daobaitou/STM32_SmartFarm/文档/详细开发计划书.md

# 基于STM32的智能农业监测与灌溉控制系统 — 详细开发计划书

> 编写时间：2026年4月17日
> 适用阶段：毕业设计实施阶段

---

## 一、开发策略原则

### 1.1 核心原则

1. **分阶段、模块化开发**：不追求一次完成所有配置，每个阶段独立验证后再进入下一阶段
2. **先验证后集成**：每个模块单独测试通过后再集成到主工程
3. **从简单到复杂**：从LED闪烁开始，逐步增加功能
4. **保留里程碑版本**：每个阶段完成后保存独立工程备份

### 1.2 开发顺序

```
阶段0: 工程框架搭建 → LED闪烁验证
阶段1: 外设驱动开发（无RTOS，裸机轮询）
阶段2: FreeRTOS集成与任务划分
阶段3: 传感器任务集成
阶段4: 灌溉控制与通信任务
阶段5: 系统联调与优化
阶段6: 上位机与云端开发（并行）
```

---

## 二、阶段0：工程框架搭建（1天）

### 2.1 目标

- 创建基础Keil工程
- 完成STM32CubeMX配置
- 验证编译下载
- LED闪烁测试

### 2.2 任务清单

| 序号 | 任务 | 详细说明 | 完成标准 |
|:----:|---|---|---|
| 0.1 | 创建工程目录 | `Code\STM32_SmartFarm\` | 目录结构完整 |
| 0.2 | CubeMX基础配置 | 按已确认的引脚分配表配置 | 无警告，生成代码成功 |
| 0.3 | Keil工程设置 | 优化等级O2，C99标准，HEX输出 | 编译0 Error 0 Warning |
| 0.4 | ST-Link下载验证 | 连接Blue Pill，下载程序 | 下载成功 |
| 0.5 | LED闪烁测试 | PC13板载LED，1秒闪烁 | LED正常闪烁 |

### 2.3 CubeMX配置要点（已确认方案）

**引脚分配最终版（无冲突）：**

```
模块分类        引脚           功能                配置说明
─────────────────────────────────────────────────────────────
RCC            PH0/PH1        HSE晶振            Crystal/Resonator
SYS            PA13/PA14      SWD调试            Serial Wire

I2C总线        PB6            I2C1_SCL           BH1750+BMP180+OLED+DS3231
               PB7            I2C1_SDA

UART通信       PA9            USART1_TX          串口调试printf (115200bps)
               PA10           USART1_RX
               PA2            USART2_TX          ESP8266 (115200bps)
               PA3            USART2_RX
               PB10           USART3_TX          MH-Z19B (9600bps)
               PB11           USART3_RX

ADC采集        PA0            ADC1_IN0           FC28土壤湿度（已验证）

EXTI中断       PB0            EXTI0              YF-S201水流脉冲（下降沿计数）
               PA5            EXTI5              LM393断电检测（双沿触发）

GPIO输出       PC13           GPIO_Output        板载LED
               PA1            GPIO_Output        DHT22数据引脚
               PA4            GPIO_Output        TB6612 AIN2 风扇控制
               PA6            GPIO_Output        DS18B20数据引脚
               PA7            TIM3_CH2 PWM       SG90舵机窗户控制(50Hz)
               PB1            GPIO_Output        继电器/水泵
               PB8            GPIO_Output        蜂鸣器（低电平触发）
               PB9            GPIO_Output        LED红灯

GPIO输入       PB12           GPIO_Input (PU)    KEY1 模式切换
               PB13           GPIO_Input (PU)    KEY2 水泵开关
               PB14           GPIO_Input (PU)    KEY3 清除报警
               PB15           GPIO_Input (PU)    KEY4 风扇+窗户
```

**时钟配置：**
```
HSE: 8MHz (外部晶振)
PLL: x9 倍频
SYSCLK: 72MHz
APB1: 36MHz (定时器2x = 72MHz)
APB2: 72MHz
```

**需要开启的中断：**
- EXTI line0 (PB0 YF-S201水流脉冲)
- EXTI line5 (PA5 LM393断电检测)
- TIM3 global interrupt (舵机PWM)
- TIM4 global interrupt (HAL timebase)
- USART2 global interrupt (ESP8266 UART)

### 2.4 需避免的引脚（Blue Pill JTAG冲突）

```
禁止使用: PA15, PB3, PB4 (JTAG引脚，即使SWD模式也有冲突)
谨慎使用: PA8 (可能有时钟相关冲突)
```

### 2.5 阶段验收

- [x] Keil工程编译成功
- [x] 程序下载成功
- [x] PC13 LED以1秒周期闪烁
- [x] 保存工程备份：已完成多个里程碑版本(v0~v1.4)

---

## 三、阶段1：外设驱动开发（5-7天）

### 1.1 目标

- 裸机环境下完成所有传感器驱动
- 通过串口打印验证每个传感器数据
- 不引入RTOS，使用简单的delay轮询

### 1.2 模块开发顺序

#### 模块1.1：串口调试输出（0.5天） ✅ 已完成

| 任务 | 说明 |
|---|---|
| 重定向printf | 使用USART1，115200bps |
| 测试代码 | `printf("System Init OK\r\n");` |
| 验收标准 | 串口助手收到打印信息 |

**代码结构：**
```
App/
├── Utils/
│   ├── retarget.c      # printf重定向
│   └── retarget.h
```

#### 模块1.2：DHT22温湿度传感器（0.5天） ✅ 已完成

| 任务 | 说明 |
|---|---|
| 接口 | PA1，单总线协议 |
| 时序要求 | 起始信号>1ms，响应80us，数据位50us周期 |
| 数据格式 | 40位（湿度整数+小数+温度整数+小数+校验和） |
| 采集周期 | ≥2秒 |

**驱动接口设计：**
```c
typedef struct {
    float temperature;    // 温度(°C)
    float humidity;       // 湿度(%RH)
    uint8_t valid;        // 数据有效标志
} DHT22_Data_t;

HAL_StatusTypeDef DHT22_Init(void);
HAL_StatusTypeDef DHT22_Read(DHT22_Data_t *data);
```

**验收标准：** 串口打印 `DHT22: T=25.6°C, H=65.2%RH`

#### 模块1.3：DS18B20土壤温度（0.5天） ✅ 已完成

| 任务 | 说明 |
|---|---|
| 接口 | PA6，单总线协议 |
| 精度 | ±0.5°C |
| 转换时间 | 750ms（12位分辨率） |

**驱动接口设计：**
```c
typedef struct {
    float temperature;    // 温度(°C)
    uint8_t valid;
} DS18B20_Data_t;

HAL_StatusTypeDef DS18B20_Init(void);
HAL_StatusTypeDef DS18B20_Read(DS18B20_Data_t *data);
```

**验收标准：** 串口打印 `DS18B20: T=22.1°C`

#### 模块1.4：BH1750光照强度（0.5天） ✅ 已完成（软件I2C）

| 任务 | 说明 |
|---|---|
| 接口 | GPIO模拟I2C (PB6/PB7) |
| 地址 | 0x23 |
| 量程 | 1-65535 lux |
| 特殊处理 | 单次触发模式 + 数据合理性校验 |

**驱动接口设计：**
```c
typedef struct {
    float light;         // 光照强度(lux)
    uint8_t valid;
} BH1750_Data_t;

HAL_StatusTypeDef BH1750_Init(void);
HAL_StatusTypeDef BH1750_Read(BH1750_Data_t *data);
```

**验收标准：** 串口打印 `BH1750: Light=850 lux`

#### 模块1.5：BMP180大气压强（0.5天） ✅ 已完成（软件I2C）

| 任务 | 说明 |
|---|---|
| 接口 | GPIO模拟I2C (PB6/PB7) |
| 地址 | 0x77 |
| 测量内容 | 大气压强(hPa) + 温度补偿 |
| 特殊处理 | EPROM校准参数读取 + Bosch补偿公式 |

**驱动接口设计：**
```c
typedef struct {
    float pressure;       // 大气压强(hPa)
    float temperature;    // 芯片温度(°C)
    uint8_t valid;
} BMP180_Data_t;

HAL_StatusTypeDef BMP180_Init(void);
HAL_StatusTypeDef BMP180_Read(BMP180_Data_t *data);
```

**验收标准：** 串口打印 `BMP180: P=1013.2 hPa`

#### 模块1.6：MH-Z19B CO2传感器（1天） ✅ 已完成

| 任务 | 说明 |
|---|---|
| 接口 | USART3 (PB10/PB11)，9600bps |
| 通信协议 | 9字节命令帧 |
| 预热时间 | 3分钟 |

**命令帧格式：**
```
读取命令: 0xFF 0x01 0x86 0x00 0x00 0x00 0x00 0x00 0x79
返回格式: 0xFF 0x86 [高字节] [低字节] ... [校验和]
```

**驱动接口设计：**
```c
typedef struct {
    uint16_t ppm;         // CO2浓度(ppm)
    uint8_t valid;
} MHZ19B_Data_t;

HAL_StatusTypeDef MHZ19B_Init(void);
HAL_StatusTypeDef MHZ19B_Read(MHZ19B_Data_t *data);
```

**验收标准：** 串口打印 `MH-Z19B: CO2=420 ppm`

#### 模块1.7：FC28土壤湿度ADC（0.5天） ✅ 已完成

| 任务 | 说明 |
|---|---|
| 接口 | ADC1_IN0 (PA0) |
| 输出范围 | 0-4095（12位ADC） |
| 湿度映射 | 干燥≈4095，湿润≈1000（需校准） |

**驱动接口设计：**
```c
HAL_StatusTypeDef FC28_Init(void);
HAL_StatusTypeDef FC28_Read(uint16_t *adc_value, uint8_t *moisture_percent);
```

**验收标准：** 串口打印 `FC28: ADC=2500, Moisture=45%`

#### 模块1.8：水位传感器ADC（0.5天）

| 任务 | 说明 |
|---|---|
| 接口 | ADC1_IN4 (PA4) |
| 输出范围 | 0-4095 |
| 水位映射 | 低水位≈500，满水≈3500（需校准） |

**验收标准：** 串口打印 `WaterLevel: 75%`

#### 模块1.9：LM393雨滴检测（0.5天）

| 任务 | 说明 |
|---|---|
| 接口 | ADC1_IN5 (PA5)，可选数字输出DO |
| 检测逻辑 | 无雨≈4095，有雨<3000 |

**验收标准：** 串口打印 `Rain: No/Yes`

#### 模块1.10：YF-S201水流传感器（1天） ✅ 驱动完成（硬件接线待确认）

| 任务 | 说明 |
|---|---|
| 接口 | PB0 (EXTI0)，下降沿中断计数 |
| 原理 | 脉冲计数，频率与流速成正比 |
| 流速公式 | 流速(L/min) = 脉冲频率 / 7.5 |

**驱动接口设计：**
```c
HAL_StatusTypeDef YFS201_Init(void);
float YFS201_GetFlowRate(void);      // 流速(L/min)
float YFS201_GetTotalVolume(void);   // 累计流量(L)
void YFS201_ResetVolume(void);
```

**验收标准：** 串口打印 `Flow: 1.2 L/min, Total: 5.6 L`

#### 模块1.11：OLED显示（1天） ✅ 已完成（软件I2C + 批量刷新）

| 任务 | 说明 |
|---|---|
| 接口 | GPIO模拟I2C (PB6/PB7) |
| 型号 | SSD1306，128x64，地址0x3C |
| 特殊处理 | 批量页刷新(8次I2C事务而非1024次) |

**驱动接口设计：**
```c
HAL_StatusTypeDef OLED_Init(void);
void OLED_Clear(void);
void OLED_Refresh(void);
void OLED_DrawString(uint8_t x, uint8_t y, const char *str, uint8_t font_size);
void OLED_Fill(uint8_t data);
```

**验收标准：** OLED显示温湿度数据

#### 模块1.12：DS3231 RTC时钟（0.5天）

| 任务 | 说明 |
|---|---|
| 接口 | I2C1 (PB6/PB7) |
| 地址 | 0xD0（写）/ 0xD1（读） |
| 功能 | 年月日时分秒，断电保持 |

**验收标准：** 串口打印 `Time: 2026-04-17 14:30:25`

#### 模块1.13：水泵控制（MOS驱动） ✅ 已完成

| 任务 | 说明 |
|---|---|
| 接口 | PB1，GPIO输出 + MOS模块 |
| 控制逻辑 | 高电平开启，低电平关闭 |
| 驱动方式 | MOS模块（5V供电），与风扇方案一致 |

**硬件接线：**
```
STM32 PB1 ─── MOS模块IN
MOS模块VCC ─── 5V
MOS模块GND ─── GND
MOS输出 ─── 12V水泵正极
水泵负极 ─── GND
```

**验收标准：** 水泵可手动/自动开关

#### 模块1.14：蜂鸣器与LED报警（0.5天）

| 任务 | 说明 |
|---|---|
| 蜂鸣器 | PB8，GPIO输出 |
| LED红灯 | PB9，GPIO输出 |

**验收标准：** 声光报警正常工作

#### 模块1.15：按键输入（0.5天）

| 任务 | 说明 |
|---|---|
| 接口 | PB12/PB13/PB14/PB15，上拉输入 |
| 检测方式 | 轮询扫描，消抖20ms |

**验收标准：** 按键触发串口打印

### 1.3 阶段验收清单

- [x] DHT22温湿度读取正常
- [x] DS18B20土壤温度读取正常
- [x] BH1750光照强度读取正常
- [x] BMP180大气压强读取正常
- [x] MH-Z19B CO2浓度读取正常（已集成，含预热+量程过滤）
- [x] FC28土壤湿度ADC读取正常
- [ ] 水位传感器ADC读取正常
- [ ] LM393雨滴检测正常
- [x] YF-S201水流计量正常（驱动完成，硬件接线已确认）
- [x] OLED显示正常
- [x] W25Q64 Flash存储正常（配置参数+数据日志）
- [x] DHT22添加4.7K上拉电阻后正常工作（26.3°C / 49%）
- [ ] DS3231时间读取正常
- [x] 水泵控制正常（PB1, MOS驱动，高电平ON）
- [x] 蜂鸣器+LED报警正常（PB8低电平触发3pin蜂鸣器+PB9 LED）
- [x] 按键响应正常（4键，50ms消抖+单次触发+短"滴"声确认）
- [x] 断电检测驱动完成（LM393比较器，PA5双沿EXTI中断）
- [x] 保存工程备份：`STM32_SmartFarm_v1_Sensors/`

---

## 四、阶段2：FreeRTOS集成（2-3天） ✅ 已完成

### 2.1 目标

- 将FreeRTOS内核集成到工程
- 创建基础任务框架
- 验证任务调度正常

### 2.2 任务清单

#### 2.1 FreeRTOS移植（1天） ✅ 已完成

| 任务 | 说明 |
|---|---|
| 源码添加 | 使用 `FreeRTOSv202411.00` |
| 配置文件 | `FreeRTOSConfig.h` 时钟72MHz，堆8KB |
| 堆管理 | 选择 `heap_4.c` |
| HAL timebase | 重写`HAL_InitTick()`用TIM4替代SysTick |
| 中断接管 | SysTick→FreeRTOS, PendSV/SVC→FreeRTOS |

**FreeRTOSConfig.h 实际配置：**
```c
#define configCPU_CLOCK_HZ          (72000000UL)
#define configTICK_RATE_HZ          (1000)        // 1ms tick
#define configTOTAL_HEAP_SIZE       ((size_t)(15 * 1024))  // 15KB
#define configUSE_PREEMPTION         1
#define configUSE_MUTEXES            1
#define configUSE_COUNTING_SEMAPHORES 1
#define configUSE_TIMERS             1
#define configMAX_PRIORITIES         (7)
```

#### 2.2 创建基础任务（1天） ✅ 已完成

**实际任务分配（v4.3 完整版）：**
```c
#define PRIORITY_IRRIGATION 6   // 灌溉+风扇+窗户+按键（独占最高优先级）
#define PRIORITY_UART_RX   4   // 接收控制命令
#define PRIORITY_SENSOR     3   // 传感器采集
#define PRIORITY_LCD        2   // OLED显示
#define PRIORITY_UART_TX    2   // 发送传感器数据
#define PRIORITY_PRINT      2   // 串口打印
#define PRIORITY_LED        0   // LED闪烁
```

**任务栈与功能：**
| 任务 | 栈(字) | 优先级 | 功能 |
|---|---|---|---|
| vTask_Irrigation | 384 | 6 | 灌溉+风扇+窗户控制、4键响应、报警判断（不用printf） |
| vTask_Sensor | 512 | 3 | 每2秒采集所有传感器（含CO2），发送队列(3份) |
| vTask_LCD | 384 | 2 | 接收数据，OLED显示（I2C互斥保护） |
| vTask_UART_TX | 256 | 2 | 接收数据，通过UART协议发送到ESP8266 |
| vTask_Print | 256 | 2 | 接收数据，串口打印（不用float printf） |
| vTask_UART_RX | 128 | 4 | 从ESP8266接收控制命令 |
| vTask_LED | 128 | 0 | PC13每500ms翻转 |

**数据通信：**
- 队列：`xQueue_SensorData`（长度3，发送3份给3个消费者）
- 队列：`xQueue_ControlCmd`（长度4，控制命令）
- 互斥量：`xMutex_I2C`（保护共享I2C总线）

**SensorData_t 结构：**
```c
typedef struct {
    float temperature, humidity, soil_temp, pressure, bmp_temp;
    float light, flow_rate, total_volume;
    uint8_t soil_moisture;
    uint16_t adc_raw, co2;
    uint32_t timestamp;
} SensorData_t;
```

#### 2.3 关键技术要点

1. **SysTick冲突解决**：重写`HAL_InitTick()`用TIM4替代SysTick
2. **中断向量映射**：SysTick_Handler→xPortSysTickHandler, PendSV→xPortPendSVHandler, SVC→vPortSVCHandler
3. **TIM4配置**：72分频→1MHz，周期1000→1ms，NVIC优先级最低(15)
4. **I2C互斥保护**：LCD任务通过mutex独占I2C总线，防止与BH1750/BMP180冲突
5. **Windows大小写问题**：`freertos.h`与`FreeRTOS.h`冲突，改名为`app_tasks.h`

#### 2.4 阶段验收

- [x] FreeRTOS编译通过
- [x] 任务调度正常（LED闪烁、串口打印、OLED刷新）
- [x] 消息队列通信正常
- [x] I2C互斥量工作正常
- [x] 保存工程备份：阶段2集成完成

---

## 五、阶段3：传感器任务集成（3-4天） ✅ 已完成（与阶段2合并）

### 3.1 目标

- 将阶段1的驱动集成到FreeRTOS任务
- 实现数据采集队列通信
- OLED实时显示

### 3.2 实际实现

传感器采集、队列通信、OLED显示已在阶段2一并实现：
- `vTask_Sensor`：每2秒采集DHT22/DS18B20/FC28/BMP180/BH1750/YFS201
- `vTask_LCD`：接收队列数据，通过I2C互斥量保护OLED刷新
- `vTask_Print`：接收队列数据，串口格式化打印

### 3.3 测试结果

```
[Sensor] DHT22 failed          ← 传感器未连接
[Sensor] FC28: 100%
[Sensor] BMP180: 803hPa
[Sensor] BH1750: 200lux
[Sensor] Data sent to queue
[LCD] OLED refreshed
[LED] Toggle #22
```

### 3.4 阶段验收

- [x] 已有传感器数据正常采集（DHT22已添加上拉电阻，26.3°C/49%正常读取）
- [x] 消息队列数据传输正常
- [x] OLED实时刷新显示
- [ ] MH-Z19B/水位/雨滴传感器待硬件到位后集成

---

## 六、阶段4：通信与灌溉控制（4-5天） ✅ 已完成（v3.0 + v4.0架构重构）

### 4.1 目标

- ESP8266 MQTT通信
- 灌溉控制逻辑
- 断电检测响应

### 4.2 架构演进（重要）

#### v3.0 旧架构（已废弃）

```
STM32(传感器+AT命令+MQTT协议编码) → ESP8266(AT被动响应)
```

STM32承担了过多通信协议处理工作，20KB RAM不足以支撑AT命令解析+MQTT协议编码+多任务栈，接上ESP8266后系统崩溃。

#### v4.0 新架构（当前方案）

```
STM32(传感器采集) ←UART文本协议→ ESP8266(Arduino独立固件+WiFi+MQTT)
```

**ESP8266独立运行Arduino固件**，自己处理WiFi连接、MQTT通信和JSON格式转换：
- 位置：`Code/ESP8266_MQTT_Bridge/`
- 库依赖：PubSubClient（MQTT）、ArduinoJson v6（JSON）
- SoftwareSerial (D7/D8) 与 STM32 通信
- 自动 WiFi + MQTT 重连

**STM32 精简**：
- 删除 `esp8266_at.c/h`（AT命令驱动）
- 删除 `esp_mqtt.c/h`（MQTT协议编码）
- 新增 `uart_bridge.c/h`（简单UART文本协议）
- 新增 `servo_control.c/h`（SG90舵机PWM驱动）
- 新增 `fan_control.c/h`（TB6612风扇GPIO驱动）
- 释放约 2.6KB RAM

### 4.3 UART文本协议

**STM32 → ESP8266**（传感器数据）：
```
SNS:{"t":25.6,"h":65.2,"sm":42,"st":22.1,"l":850,"p":1013.2,"c":420,"f":0.0,"v":0.0}\n
```

**ESP8266 → STM32**（控制命令）：
```
CMD:MODE:AUTO\n      /  CMD:MODE:MANUAL\n
CMD:PUMP:ON\n        /  CMD:PUMP:OFF\n
CMD:THRESH:35:70\n
CMD:FAN:ON\n         /  CMD:FAN:OFF\n
CMD:WDOW:OPEN\n      /  CMD:WDOW:CLOSE\n
ACK:SNS\n            /  NACK:SNS\n
```

### 4.4 STM32通信任务

```c
// UART_TX任务 - 发送传感器数据到ESP8266
void vTask_UART_TX(void *pvParameters)
{
    SensorData_t data;
    for (;;) {
        if (xQueueReceive(xQueue_SensorData, &data, portMAX_DELAY) == pdTRUE) {
            UART_Bridge_SendSensorData(&data);
        }
    }
}

// UART_RX任务 - 接收ESP8266控制命令
void vTask_UART_RX(void *pvParameters)
{
    BridgeCmd_t bridgeCmd;
    ControlCmd_t ctrlCmd;
    for (;;) {
        if (UART_Bridge_CheckCommand(&bridgeCmd)) {
            // 转换并放入控制命令队列
            xQueueSend(xQueue_ControlCmd, &ctrlCmd, 0);
        }
        vTaskDelay(pdMS_TO_TICKS(100));
    }
}
```

### 4.5 接线（v4.0 确认）

| STM32 | ESP-12E NodeMCU | 说明 |
|---|---|---|
| PA2 (USART2_TX) | D8 (GPIO15) SoftwareSerial RX | 发送传感器数据 |
| PA3 (USART2_RX) | D7 (GPIO13) SoftwareSerial TX | 接收控制命令 |
| GND | GND | 共地 |

> ESP8266硬件UART0 (GPIO1/GPIO3) 留给USB调试和烧录，NodeMCU板载CH340占用这两个引脚。

### 4.6 MQTT通信（ESP8266处理）

| 项目 | 配置 |
|---|---|
| WiFi SSID | KmustAuto |
| MQTT Broker | 124.223.5.91:1883 |
| MQTT Client | farm_001_esp |
| 上行Topic | smartfarm/farm_001/sensor/data |
| 下行Topic | smartfarm/farm_001/control/mode, pump, fan, window |
| 配置Topic | smartfarm/farm_001/config/threshold |

### 4.7 灌溉控制逻辑 ✅ 已完成

灌溉控制任务 `vTask_Irrigation` 已实现，支持：

**控制模式**：
- 自动模式（默认）：土壤湿度低于阈值低限自动开泵，高于阈值高限自动关泵
- 手动模式：通过按键或MQTT远程控制水泵开关

**按键控制**（50ms消抖+单次触发）：
- KEY1（PB12）：切换自动/手动模式（短"滴"声确认）
- KEY2（PB13）：手动开关水泵（短"滴"声确认）
- KEY3（PB14）：清除报警（短"滴"声确认）
- KEY4（PB15）：切换风扇+窗户状态（短"滴"声确认）

**远程控制**：通过UART协议接收ESP8266转发的MQTT命令
- `CMD:MODE:AUTO` / `CMD:MODE:MANUAL`：模式切换
- `CMD:PUMP:ON` / `CMD:PUMP:OFF`：水泵控制
- `CMD:THRESH:35:70`：设置湿度阈值
- `CMD:FAN:ON` / `CMD:FAN:OFF`：风扇控制
- `CMD:WDOW:OPEN` / `CMD:WDOW:CLOSE`：窗户控制

**安全保护**：
- `last_soil > 0` 守卫：确保有有效土壤读数后才触发自动灌溉
- 报警联动：土壤过干触发蜂鸣器+LED报警

**阈值默认值**：低限30%，高限70%

### 4.8 自动环境调节 ✅ 已完成

**风扇控制**（PA4，TB6612驱动）：
- 高温阈值：>35°C 自动开启，<32°C 自动关闭
- 手动控制：KEY4按键或MQTT `CMD:FAN:ON/OFF`

**窗户控制**（PA7，TIM3 PWM 50Hz驱动SG90）：
- 高湿阈值：>80% 自动开窗，<75% 自动关窗
- 手动控制：KEY4按键或MQTT `CMD:WDOW:OPEN/CLOSE`

**自动逻辑**：
- 高温时：自动开风扇+开窗（双重降温）
- 高湿时：自动开窗（通风除湿）
- 手动KEY4：全开/全关切换（风扇+窗户同步）

### 4.9 断电检测 ✅ 已完成

**方案**：LM393比较器 + PA5双沿EXTI中断

**硬件原理**：
- 12V适配器经10K+10K分压（~6V）接到LM393 IN+
- 3.3V参考电压接LM393 IN-
- LM393开路集电极输出接PA5（10K上拉到3.3V）
- 市电正常：IN+(6V) > IN-(3.3V) → OUT=LOW → PA5低电平
- 市电断开：IN+(0V) < IN-(3.3V) → OUT=HIGH → PA5高电平

**检测方式**：PA5配置为`GPIO_MODE_IT_RISING_FALLING`双沿中断
- 上升沿（PA5→HIGH）：市电断开，`PowerDetect_SetBackup()`
- 下降沿（PA5→LOW）：市电恢复，`PowerDetect_SetMain()`

**响应动作**：
- 断电时：关闭风扇/窗户，500ms长鸣报警，OLED显示"BAT"
- 恢复时：短"滴"确认，OLED显示"AC"

**检测点位置**：LM393采样点在二极管OR电路之前（12V适配器侧），可区分市电和备用电池

### 4.10 已解决的关键问题（v4.2~v4.3）

| 问题 | 原因 | 解决方案 |
|---|---|---|
| Irrigation任务崩溃 | ARMCC V5 printf消耗~1.5KB栈，超出384words | 改用debug_print直接寄存器输出（~50B栈） |
| Irrigation任务无法启动 | 优先级4与UART_RX共享，调度器无法调度 | 独占最高优先级6 |
| FreeRTOS堆不足 | 12KB不够7个任务+队列+互斥量 | 增至15KB |
| 蜂鸣器一直响 | GPIO_PULLUP与蜂鸣器模块内部电路冲突 | 改为GPIO_NOPULL |
| 按键长按反复触发 | 原消抖逻辑每200ms返回1 | 添加fired[]单次触发机制 |
| 按键无反馈 | 按下后无声音确认 | 添加Alarm_Click() 20ms短"滴"声 |

### 4.11 阶段验收

- [x] ESP8266连接WiFi成功
- [x] MQTT连接成功
- [x] 数据上传到服务器（MQTTX验证）
- [x] 接收下行控制命令（CMD:PUMP:ON验证）
- [x] STM32 + ESP8266长时间稳定运行（100+采集循环无崩溃）
- [x] 灌溉逻辑正常执行（自动/手动模式、按键控制、远程控制）
- [x] 报警功能正常（土壤过干声光报警、按键清除）
- [x] 风扇控制正常（PA4, TB6612, 自动温度触发）
- [x] 舵机窗户控制正常（PA7, TIM3 PWM 50Hz, 自动湿度触发）
- [x] KEY4按键正常（切换风扇+窗户，短"滴"声确认）
- [x] 按键单次触发+确认音（50ms消抖+fired[]机制）
- [x] 断电检测模块完成（LM393+PA5双沿EXTI，代码已就绪，待硬件搭建测试）

---

## 七、阶段5：系统联调优化（2-3天）

### 5.1 目标

- 整体功能联调
- 异常处理完善
- 性能优化

### 5.2 任务清单

| 任务 | 说明 |
|---|---|
| 内存优化 | 检查FreeRTOS堆栈使用 |
| 低功耗模式 | 断电后降低采集频率 |
| 断网重连 | MQTT自动重连机制 |
| 数据缓存 | 断网时缓存数据到Flash |
| 看门狗 | 添加IWDG防止死机 |
| 参数存储 | Flash保存配置参数 |

### 5.3 阶段验收

- [ ] 长时间运行稳定（>24小时）
- [ ] 断网自动重连
- [ ] 断电切换正常
- [ ] 保存工程备份：`STM32_SmartFarm_v5_Final/`

---

## 八、阶段6：上位机与云端（并行开发）

### 6.1 QT上位机（2-3周）

#### 6.1.1 功能模块

| 模块 | 功能 |
|---|---|
| 实时监控 | 显示传感器数据卡片 |
| 历史曲线 | QChart绘制趋势图 |
| 灌溉控制 | 模式切换、手动控制 |
| 数据导出 | CSV导出 |
| 系统设置 | MQTT配置、阈值设置 |

#### 6.1.2 开发顺序

1. 环境搭建（Qt Creator + Qt 6）
2. MQTT客户端集成（QtMqtt模块）
3. 主界面开发
4. 数据库存储（SQLite）
5. 历史曲线
6. 控制面板
7. 设置页面

### 6.2 Flask Web端（1-2周） ✅ 已完成

#### 6.2.1 功能模块

| 模块 | 功能 | 状态 |
|---|---|---|
| MQTT桥接 | 订阅设备数据，存储到SQLite | ✅ |
| REST API | 数据查询（latest/history/stats）、控制命令 | ✅ |
| 仪表盘 | 卡片式9传感器实时数据，2秒自动刷新 | ✅ |
| 历史数据 | 9个传感器独立卡片+Chart.js趋势曲线+统计 | ✅ |
| 远程控制 | 模式切换、水泵/风扇/窗户控制、阈值设置 | ✅ |
| 原始数据表 | 折叠式表格，可展开查看全部字段 | ✅ |

#### 6.2.2 技术实现

**架构**：
```
STM32 ──UART──→ ESP8266 ──MQTT──→ Mosquitto (124.223.5.91:1883)
                                        │
                                   Flask + paho-mqtt（后台线程订阅）
                                   ├── SQLite（/data/smartfarm.db）
                                   ├── Jinja2 模板渲染
                                   ├── Chart.js CDN（趋势曲线）
                                   └── REST API（JSON）
                                        │
                                   Gunicorn (127.0.0.1:5000, 1 worker)
                                        │
                                   Nginx 反向代理 (:80)
```

**服务器环境**：
| 项目 | 配置 |
|---|---|
| OS | OpenCloudOS 9.4（腾讯云自研，类CentOS） |
| Python | 3.11.6 + venv |
| Nginx | 1.26.3（conf.d目录配置） |
| Mosquitto | 已部署运行（端口1883） |
| systemd | smartfarm.service（开机自启） |

**项目文件结构**：
```
Web/
├── app.py              # Flask主程序 + MQTT订阅 + REST API
├── config.py           # MQTT/DB配置（Windows/服务器自适应路径）
├── requirements.txt    # Flask 3.0 + paho-mqtt 1.6 + gunicorn 21.2
├── templates/
│   ├── base.html       # 基础布局（移动端viewport）
│   ├── dashboard.html  # 仪表盘（9卡片+2秒轮询刷新）
│   ├── history.html    # 历史数据（Chart.js趋势曲线+统计+折叠表格）
│   └── control.html    # 远程控制面板
├── static/
│   ├── style.css       # 移动端适配样式
│   └── script.js       # 共用JS
├── deploy.sh           # 一键部署脚本
├── smartfarm.service   # systemd服务配置
└── nginx.conf          # Nginx反向代理配置
```

**REST API**：
| 路由 | 方法 | 功能 |
|---|---|---|
| `/api/latest` | GET | 最新一条传感器数据 |
| `/api/history?hours=N` | GET | 历史N小时数据 |
| `/api/stats` | GET | 数据库统计信息 |
| `/api/control/<device>` | POST | 控制命令（mode/pump/fan/window/threshold） |

**关键设计决策**：
1. 服务器时间戳：STM32无RTC，使用服务器`time.time()`替代FreeRTOS tick计数
2. 单worker模式：gunicorn `-w 1`，避免多进程全局状态不共享
3. 模块级MQTT启动：MQTT线程在模块导入时启动（兼容gunicorn fork模型）
4. Chart.js CDN：轻量折线图（~60KB），无需构建工具
5. 移动优先：viewport meta + flex布局，手机直接访问IP即可

**历史页面设计**（v5.1升级）：
- 9个传感器独立卡片，每个含Chart.js趋势折线图
- 左侧彩色边框区分参数（红=温度、蓝=湿度、棕=土壤等）
- 每个卡片显示当前值 + 最小/最大/平均统计
- 时间范围按钮组（1h/6h/24h/3天）
- 底部折叠式原始数据表

**部署步骤（实际操作）**：
1. SCP上传Web目录到`/opt/smartfarm/`
2. `python3 -m venv venv && pip install -r requirements.txt`
3. 初始化SQLite数据库
4. 创建systemd服务（gunicorn -w 1 -b 127.0.0.1:5000）
5. 创建Nginx反向代理配置（conf.d/smartfarm.conf）
6. 备份原有网站配置，启用SmartFarm配置

**与招聘系统共存**：
```bash
# 切换到SmartFarm
mv /etc/nginx/conf.d/recruitment_system.conf{,.bak}
mv /etc/nginx/conf.d/smartfarm.conf{.bak,}
systemctl start smartfarm && systemctl reload nginx

# 切换到招聘系统
mv /etc/nginx/conf.d/smartfarm.conf{,.bak}
mv /etc/nginx/conf.d/recruitment_system.conf{.bak,}
systemctl stop smartfarm && systemctl reload nginx
```

---

## 九、测试验收清单

### 9.1 功能测试

| 功能 | 测试方法 | 通过标准 |
|---|---|---|
| 传感器采集 | 串口打印数据 | 数据在合理范围内 |
| OLED显示 | 目视检查 | 刷新正常，无乱码 |
| MQTT上行 | 服务器端订阅 | 数据延迟<2秒 |
| MQTT下行 | 发送控制命令 | 命令执行正确 |
| 自动灌溉 | 降低土壤湿度 | 自动启动水泵 |
| 手动灌溉 | 按键/远程控制 | 手动开关水泵 |
| 降雨暂停 | 模拟降雨 | 暂停灌溉 |
| 低水位报警 | 低水位触发 | 报警+禁止水泵 |
| 断电切换 | 断开市电 | 切换备用模式 |
| 断网重连 | 断开WiFi | 自动重连 |

### 9.2 性能测试

| 指标 | 目标值 |
|---|---|
| 通信延迟 | <2秒 |
| 数据丢失率 | <1% |
| 连续运行 | >24小时无死机 |
| 内存占用 | <16KB |

---

## 十、开发环境与工具

### 10.1 软件工具

| 工具 | 版本 | 用途 |
|---|---|---|
| Keil MDK | V5.38 | STM32开发 |
| STM32CubeMX | 6.x | 工程配置生成 |
| Qt Creator | 10.x | 上位机开发 |
| Python | 3.10+ | Web后端 |
| VS Code | - | 通用编辑器 |
| 串口助手 | - | 调试输出 |

### 10.2 硬件工具

| 工具 | 用途 |
|---|---|
| ST-Link V2 | 程序下载调试 |
| USB-TTL (CH340) | 串口调试 |
| 逻辑分析仪 | 时序调试 |
| 万用表 | 电路检测 |

---

## 十一、风险与应对

| 风险 | 可能性 | 影响 | 应对措施 |
|---|---|---|---|
| 传感器驱动时序问题 | 中 | 高 | 先用逻辑分析仪验证时序 |
| FreeRTOS堆栈溢出 | 中 | 高 | 使用`uxTaskGetStackHighWaterMark()`监控 |
| ESP8266通信不稳定 | 中 | 高 | 增加重试机制和看门狗 |
| 内存不足 | 低 | 高 | 优化任务堆栈，使用静态分配 |
| 云服务器部署问题 | 低 | 中 | 先本地测试，再部署云端 |

---

## 十二、里程碑与版本管理

| 版本 | 内容 | 预计完成 | 实际完成 |
|---|---|---|---|
| v0 | LED闪烁 | 第1天 | ✅ 2026-04-17 |
| v1.1 | printf + DHT22 + DS18B20 | 第3天 | ✅ 2026-04-18 |
| v1.2 | FC28土壤湿度ADC | 第4天 | ✅ 2026-04-18 |
| v1.3 | OLED + BH1750 + GPIO模拟I2C | 第5天 | ✅ 2026-04-20 |
| v1.4 | BMP180大气压强 | 第6天 | ✅ 2026-04-20 |
| v1.5 | YF-S201水流 + 全传感器串口/OLED | 第7天 | ✅ 2026-04-20 |
| v2.0 | FreeRTOS集成 + 传感器任务 | 第10天 | ✅ 2026-04-20 |
| v2.1 | W25Q64 Flash存储（软件SPI+配置+日志） | 第11天 | ✅ 2026-04-21 |
| v1.6 | MH-Z19B CO2 | 第8天 | ✅ 2026-05-13（含预热+量程过滤） |
| v2.2 | 水位/雨滴传感器 | 第9天 | 待开发（硬件未到位） |
| v3.0 | ESP8266 AT命令 + MQTT协议编码 | 第14天 | ✅ 2026-05-10（已废弃） |
| v4.0 | ESP8266独立Arduino固件架构重构 | 第15天 | ✅ 2026-05-12 |
| v4.1 | 灌溉控制逻辑 + 报警 + CO2传感器集成 | 第19天 | ✅ 2026-05-14 |
| v4.2 | 稳定性修复（printf栈溢出+蜂鸣器+按键消抖+优先级+堆空间） | 第20天 | ✅ 2026-05-15 |
| v4.3 | 风扇+舵机窗户+KEY4+自动温湿度控制 | 第21天 | ✅ 2026-05-15 |
| v4.4 | 断电检测（LM393比较器+PA5双沿EXTI） | 第22天 | ✅ 2026-05-15（代码就绪，待硬件测试） |
| v5.0 | Flask Web部署（Gunicorn+Nginx+SQLite） | 第28天 | ✅ 2026-05-17 |
| v5.1 | 历史页面重新设计（Chart.js趋势曲线+统计卡片） | 第29天 | ✅ 2026-05-17 |
| v5 | 系统联调完成 | 第23天 | 待开发 |
| v6 | QT上位机完成 | 第35天 | 待开发 |

**当前进度：v5.1完成，Flask Web端已部署到腾讯云（124.223.5.91），含仪表盘+历史曲线+远程控制**

---

## 附录A：代码目录结构

```
Code/
├── STM32_SmartFarm/
│   ├── Core/
│   │   ├── Src/
│   │   │   ├── main.c              # 主程序入口，FreeRTOS启动
│   │   │   ├── stm32f1xx_it.c      # 中断处理（SysTick→FreeRTOS, TIM4→HAL, EXTI0→YFS201）
│   │   │   ├── tim.c               # TIM4 HAL timebase（HAL_InitTick重写）
│   │   │   ├── gpio.c / adc.c / usart.c
│   │   │   └── retarget.c          # printf重定向
│   │   └── Inc/
│   │       ├── FreeRTOSConfig.h    # FreeRTOS内核配置
│   │       ├── stm32f1xx_hal_conf.h  # HAL模块启用（含TIM）
│   │       └── tim.h
│   ├── Drivers/
│   │   ├── STM32F1xx_HAL_Driver/   # 含hal_tim.c, hal_tim_ex.c
│   │   └── CMSIS/
│   ├── Middlewares/
│   │   └── FreeRTOS/               # FreeRTOSv202411.00
│   │       ├── Source/
│   │       │   ├── tasks.c, queue.c, timers.c, ...
│   │       │   ├── portable/ARM_CM3/port.c
│   │       │   └── portable/MemMang/heap_4.c
│   ├── App/
│   │   ├── Sensors/
│   │   │   ├── sensor_dht22.c/h    ✅
│   │   │   ├── sensor_ds18b20.c/h  ✅
│   │   │   ├── sensor_bh1750.c/h   ✅
│   │   │   ├── sensor_bmp180.c/h   ✅
│   │   │   ├── sensor_fc28.c/h     ✅
│   │   │   ├── sensor_yfs201.c/h   ✅
│   │   │   ├── sensor_mhz19b.c/h   ✅ CO2传感器（UART3, 9600bps）
│   │   ├── Display/
│   │   │   ├── display_oled.c/h    ✅
│   │   │   └── oled_font.h
│   │   ├── Drivers/
│   │   │   ├── soft_i2c.c/h        ✅
│   │   │   └── soft_spi.c/h        ✅
│   │   ├── Storage/
│   │   │   ├── w25q_flash.c/h      ✅ (W25Q64, 8MB)
│   │   │   └── storage_manager.c/h ✅ (配置+日志)
│   │   ├── Tasks/
│   │   │   └── app_tasks.c/h       ✅ (Sensor/LCD/Print/LED/UART_TX/UART_RX/Irrigation)
│   │   ├── Communication/
│   │   │   ├── uart_bridge.c/h      ✅ (UART文本协议, 含CO2字段)
│   │   │   ├── usart2_driver.c/h    ✅ (USART2环形缓冲)
│   │   │   ├── esp8266_at.c/h       已删除(v4.0废弃)
│   │   │   └── esp_mqtt.c/h         已删除(v4.0废弃)
│   │   ├── Control/
│   │   │   ├── pump_control.c/h     ✅ 水泵控制（PB1 MOS驱动，高电平ON）
│   │   │   ├── fan_control.c/h      ✅ 风扇控制（PA4, TB6612驱动）
│   │   │   ├── servo_control.c/h    ✅ 舵机窗户控制（PA7, TIM3 PWM 50Hz）
│   │   │   └── power_detect.c/h     ✅ 断电检测（PA5, LM393+EXTI双沿中断）
│   │   └── Alarm/
│   │       └── alarm_driver.c/h     ✅ 声光报警（PB8蜂鸣器+PB9 LED）
│   └── MDK-ARM/
│       └── STM32_SmartFarm.uvprojx
├── ESP8266_MQTT_Bridge/               ✅ ESP8266独立Arduino固件
│   ├── ESP8266_MQTT_Bridge.ino        # 主程序（WiFi+MQTT+JSON）
│   └── config.h                       # WiFi/MQTT/引脚配置
├── Web/                               ✅ Flask Web端（腾讯云部署）
│   ├── app.py                         # Flask主程序 + MQTT订阅 + REST API
│   ├── config.py                      # MQTT/DB配置（自适应路径）
│   ├── requirements.txt               # Python依赖
│   ├── templates/                     # Jinja2 HTML模板
│   │   ├── base.html                  # 基础布局
│   │   ├── dashboard.html             # 仪表盘（9传感器卡片）
│   │   ├── history.html               # 历史数据（Chart.js曲线）
│   │   └── control.html               # 远程控制面板
│   ├── static/                        # 静态资源
│   │   ├── style.css                  # 移动端适配样式
│   │   └── script.js                  # 共用JS
│   ├── deploy.sh                      # 一键部署脚本
│   ├── smartfarm.service              # systemd服务配置
│   └── nginx.conf                     # Nginx反向代理配置
```

---

## 附录B：参考资料

1. STM32F103C8T6数据手册
2. FreeRTOS官方文档：https://www.freertos.org/
3. DHT22数据手册
4. ESP8266 AT指令集
5. MQTT协议规范
6. Qt 6官方文档
7. Flask官方文档

---

**文档结束**

*本开发计划书将根据实际开发进度动态更新*
