daobaitou/STM32_SmartFarm/文档/接线说明文档.md

# STM32智能农业监测系统 - 接线说明文档

## 主控芯片

| 参数 | 值 |
|---|---|
| 型号 | STM32F103C8T6 (Blue Pill) |
| 系统时钟 | 72MHz (HSE 8MHz × PLL 9) |
| 供电 | 3.3V (板载LDO) |

---

## 调试与串口

### DAP调试器 (CMSIS-DAP)

| DAP引脚 | STM32引脚 | 说明 |
|---|---|---|
| SWDIO | SWDIO | 数据 |
| SWCLK | SWCLK | 时钟 |
| GND | GND | 共地 |
| 3.3V | 3.3V | 供电(可选) |

### CH340 USB转串口 (printf调试)

| CH340引脚 | STM32引脚 | 说明 |
|---|---|---|
| TXD | PA10 (USART1_RX) | TX接RX，交叉连接 |
| RXD | PA9 (USART1_TX) | RX接TX，交叉连接 |
| 5V | - | 可给外部5V传感器供电 |
| GND | GND | 共地 |

> 串口参数：115200bps, 8N1

---

## 传感器模块

### DHT22 空气温湿度 (AM2302)

| DHT22引脚 | STM32引脚 | 说明 |
|---|---|---|
| VCC (+) | 5V (CH340) | 3.3~5.5V |
| DATA | PA1 | 单总线，模块自带上拉电阻 |
| GND (-) | GND | 共地 |

> 采集周期：2秒

### DS18B20 土壤温度（防水探头）

| DS18B20引脚 | STM32引脚 | 说明 |
|---|---|---|
| VCC (红) | 3.3V | 3.0~5.5V |
| DATA (黄) | PA6 | 单总线，模块自带上拉电阻 |
| GND (黑) | GND | 共地 |

> 采集周期：2秒，12位精度转换需750ms

### FC28 土壤湿度

| FC28引脚 | STM32引脚 | 说明 |
|---|---|---|
| VCC | 3.3V | 3.3~5V |
| AOUT | PA0 (ADC1_IN0) | 模拟量输出 |
| GND | GND | 共地 |

> 采集周期：1秒，ADC值范围0~4095

### BH1750 光照强度

| BH1750引脚 | STM32引脚 | 说明 |
|---|---|---|
| VCC | 3.3V | 3.3~5V |
| SDA | PB7 (I2C1_SDA) | I2C数据 |
| SCL | PB6 (I2C1_SCL) | I2C时钟 |
| ADDR | GND/悬空 | 地址选择(0x23) |
| GND | GND | 共地 |

> 采集周期：1秒，I2C地址：0x23(ADDR=GND) / 0x5C(ADDR=HIGH)

### MH-Z19B CO2浓度

| MH-Z19B引脚 | STM32引脚 | 说明 |
|---|---|---|
| VCC (红) | 5V | 4.5~5.5V |
| TX | PA3 (USART2_RX) | 交叉连接 |
| RX | PA2 (USART2_TX) | 交叉连接 |
| GND (黑) | GND | 共地 |

> 采集周期：5秒，UART 9600bps 8N1

### BMP180 大气压强

| BMP180引脚 | STM32引脚 | 说明 |
|---|---|---|
| VCC | 3.3V | 3.3~5V |
| SDA | PB7 (I2C1_SDA) | 与BH1750共用I2C总线 |
| SCL | PB6 (I2C1_SCL) | 与BH1750共用I2C总线 |
| GND | GND | 共地 |

> 采集周期：2秒，I2C地址：0x77

### LM393 雨滴检测

| LM393引脚 | STM32引脚 | 说明 |
|---|---|---|
| VCC | 3.3V | 3.3~5V |
| AOUT | PA4 (ADC) | 模拟量(备用，可只接DO) |
| DOUT | PA5 (GPIO_EXTI) | 数字输出，有雨=低电平 |
| GND | GND | 共地 |

> 实时检测，中断触发

---

## 数据存储

### W25Q64 SPI Flash (8MB)

| W25Q引脚 | STM32引脚 | 说明 |
|---|---|---|
| VCC | 3.3V | 3.3V供电 |
| GND | GND | 共地 |
| CS | PA15 | 片选（低电平选中），NOJTAG释放 |
| CLK | PB3 | SPI时钟，NOJTAG释放 |
| DI | PB4 | 数据输入(MOSI)，NOJTAG释放 |
| DO | PB5 | 数据输出(MISO) |
| HOLD | 3.3V | 悬空或接高，不使用暂停功能 |
| WP | 3.3V | 悬空或接高，不使用写保护 |

> 软件SPI (Mode 0)，已验证：Manuf=0xEF(Winbond), ID=0x4017(W25Q64)
> 存储用途：系统配置参数(Sector 0) + 传感器数据日志(Sector 1-2)

---

## 灌溉系统

### YF-S201 水流传感器

| YF-S201引脚 | STM32引脚 | 说明 |
|---|---|---|
| VCC (红) | 5V | 5~18V |
| SIGNAL (黄) | PB0 (EXTI0) | 脉冲输出，下降沿中断计数 |
| GND (黑) | GND | 共地 |

> 实时计数，脉冲频率 ∝ 水流量 (Flow[L/min] = F[Hz] / 7.5)
> 测试方法：吹气模拟，或杜邦线反复触碰GND模拟脉冲

### 水位传感器

| 水位传感器引脚 | STM32引脚 | 说明 |
|---|---|---|
| VCC | 3.3V | 3.3~5V |
| AOUT | PA2 (ADC) | 模拟量输出 |
| GND | GND | 共地 |

> 采集周期：1秒

### MOS水泵驱动

| MOS模块引脚 | STM32引脚 | 说明 |
|---|---|---|
| VCC | 5V | 5V供电 |
| IN | PB1 (GPIO) | 高电平=开启，低电平=关闭 |
| GND | GND | 共地 |
| OUT | 12V水泵正极 | MOS输出驱动水泵 |

### 12V直流水泵

| 水泵 | 连接 | 说明 |
|---|---|---|
| 红线 (+) | MOS模块OUT | MOS驱动控制通断 |
| 黑线 (-) | 12V电源GND | 直接接地 |
| 12V (+) | MOS模块VCC(负载端) | 12V供电 |

---

## 人机交互

### 0.96寸 OLED显示屏 (SSD1306)

| OLED引脚 | STM32引脚 | 说明 |
|---|---|---|
| VCC | 3.3V | 3.3~5V |
| SDA | PB7 (I2C1_SDA) | 与BH1750/BMP180共用I2C |
| SCL | PB6 (I2C1_SCL) | 与BH1750/BMP180共用I2C |
| GND | GND | 共地 |

> I2C地址：0x3C，128×64分辨率

### DS3231 RTC时钟

| DS3231引脚 | STM32引脚 | 说明 |
|---|---|---|
| VCC | 3.3V | 3.0~5.5V |
| SDA | PB7 (I2C1_SDA) | 共用I2C总线 |
| SCL | PB6 (I2C1_SCL) | 共用I2C总线 |
| GND | GND | 共地 |

> I2C地址：0x68，CR1220备用电池

### 蜂鸣器 (有源，低电平触发，3pin)

| 蜂鸣器引脚 | STM32引脚 | 说明 |
|---|---|---|
| VCC | 5V | 供电 |
| I/O | PB8 (GPIO) | 低电平触发，HIGH=静音，LOW=响 |
| GND | GND | 共地 |

> 推挽输出（GPIO_NOPULL），Alarm_Click()短20ms确认音

### LED报警灯

| LED | STM32引脚 | 说明 |
|-----|---|---|
| + | PB9 (GPIO) | 限流电阻串联 |
| - | GND | - |

### 按键 (4个轻触按键)

| 按键 | STM32引脚 | 功能 | 说明 |
|---|---|---|---|
| KEY1 | PB12 (GPIO) | 切换自动/手动模式 | 上拉输入，按下接地 |
| KEY2 | PB13 (GPIO) | 手动开关水泵 | 上拉输入 |
| KEY3 | PB14 (GPIO) | 清除报警 | 上拉输入 |
| KEY4 | PB15 (GPIO) | 切换风扇+窗户 | 上拉输入 |

> 50ms消抖，单次触发（按下只响应一次），短"滴"声确认

### SG90舵机 (窗户通风控制)

| 舵机引脚 | STM32引脚 | 说明 |
|---|---|---|
| 棕线 (GND) | GND | 共地 |
| 红线 (VCC) | 5V | 5V供电 |
| 橙线 (信号) | PA7 (TIM3_CH2) | 硬件PWM 50Hz |

> TIM3 PWM: 0°=CCR500(关窗), 90°=CCR1500(开窗)

### TB6612风扇电机驱动

| TB6612引脚 | 连接 | 说明 |
|---|---|---|
| AIN2 | PA4 (GPIO) | 方向控制，高电平=正转 |
| AIN1 | GND | 固定接地 |
| PWMA | 5V | 全速运行 |
| STBY | 5V | 使能 |
| VM | 5V | 电机电源 |
| VCC | 3.3V | 逻辑电源 |
| GND | GND | 共地 |
| AO1/AO2 | 微型电机 | 风扇叶片电机 |

---

## 通信模块

### ESP8266 WiFi (ESP-01S)

| ESP8266引脚 | STM32引脚 | 说明 |
|---|---|---|
| VCC | 3.3V | 3.3V(需稳定供电，峰值电流300mA) |
| TX | PA3 (USART2_RX) | 交叉连接 |
| RX | PA2 (USART2_TX) | 交叉连接 |
| CH_PD (EN) | 3.3V | 使能，10K上拉 |
| RST | 悬空/PB14 | 复位(可选MCU控制) |
| GND | GND | 共地 |

> UART 115200bps(默认) / MQTT通信

---

## 电源系统

### 双电源架构

```
12V适配器 ──→ LM2596降压(5V) ──→ STM32(3.3V LDO) + 传感器(5V)
                                        │
18650×2 (7.4V) ──→ 二极管OR电路 ────────┘
                   (市电优先)
```

| 电源 | 输出 | 说明 |
|---|---|---|
| 12V适配器 | 12V | 主电源，经降压后供电 |
| 18650×2 | 7.4V | 备用电池 |
| LM2596 | 5V | 降压模块 |
| STM32 LDO | 3.3V | 板载稳压 |

### 断电检测（LM393比较器）

| LM393引脚 | 连接 | 说明 |
|---|---|---|
| IN+ (输入端) | 12V分压网络 | 10K+10K分压，12V→6V |
| IN- (参考端) | STM32 3.3V | 参考电压 |
| OUT (输出端) | PA5 (GPIO_EXTI5) | 开路集电极，需10K上拉到3.3V |
| VCC | 5V | 比较器供电 |
| GND | GND | 共地 |

**分压网络：**
```
12V适配器 ──┬──→ 二极管 ──→ LM2596(5V) ──→ STM32
            │
            └──→ [10KΩ] ──┬──→ LM393 IN+
                          │
                          └──→ [10KΩ] ──→ GND (分压得~6V)
```

**检测逻辑：**
| 电源状态 | IN+电压 | OUT输出 | PA5电平 | 中断 |
|---|---|---|---|---|
| 市电正常 | ~6V > 3.3V | LOW | 低电平 | 无 |
| 市电断开 | ~0V < 3.3V | HIGH(上拉) | 高电平 | 上升沿触发 |

**响应动作：**
- 断电时：关闭风扇/窗户，长鸣500ms报警，OLED显示"BAT"
- 恢复时：短"滴"确认，OLED显示"AC"

---

## 引脚分配总表

| 引脚 | 功能 | 外设 | 状态 |
|---|---|---|---|
| PA0 | FC28土壤湿度 | ADC1_IN0 | ✓ 已完成 |
| PA1 | DHT22温湿度 | GPIO | ✓ 已完成 |
| PA2 | ESP8266 TX (USART2) | USART2_TX | ✓ 已完成 |
| PA3 | ESP8266 RX (USART2) | USART2_RX | ✓ 已完成 |
| PA4 | TB6612 AIN2 风扇控制 | GPIO | ✓ 已完成 |
| PA5 | 断电检测 (LM393 OUT) | EXTI5 双沿 | ✓ 已完成 |
| PA6 | DS18B20土壤温度 | GPIO | ✓ 已完成 |
| PA7 | SG90舵机 PWM | TIM3_CH2 | ✓ 已完成 |
| PA9 | USART1_TX (printf) | USART1 | ✓ 已完成 |
| PA10 | USART1_RX (printf) | USART1 | ✓ 已完成 |
| PA15 | W25Q SPI_CS | GPIO | ✓ 已完成 |
| PB0 | YF-S201水流脉冲 | EXTI0 | ✓ 已完成 |
| PB1 | MOS水泵控制 | GPIO | ✓ 已完成 |
| PB3 | W25Q SPI_CLK | GPIO | ✓ 已完成 |
| PB4 | W25Q SPI_DI (MOSI) | GPIO | ✓ 已完成 |
| PB5 | W25Q SPI_DO (MISO) | GPIO | ✓ 已完成 |
| PB6 | I2C1_SCL (软件I2C) | GPIO | ✓ 已完成 |
| PB7 | I2C1_SDA (软件I2C) | GPIO | ✓ 已完成 |
| PB8 | 蜂鸣器(低电平触发) | GPIO | ✓ 已完成 |
| PB9 | LED报警灯 | GPIO | ✓ 已完成 |
| PB12 | KEY1 模式切换 | GPIO | ✓ 已完成 |
| PB13 | KEY2 水泵开关 | GPIO | ✓ 已完成 |
| PB14 | KEY3 清除报警 | GPIO | ✓ 已完成 |
| PB15 | KEY4 风扇+窗户 | GPIO | ✓ 已完成 |
| PC13 | 板载LED | GPIO | ✓ 已完成 |

---

## I2C总线共享

```
PB6 (SCL) ─┬── BH1750 (0x23)
            ├── BMP180 (0x77)
            ├── OLED SSD1306 (0x3C)
            └── DS3231 (0x68)
PB7 (SDA) ──┘
```

> 注意：多个I2C设备共用总线，地址不能冲突

---

## SPI总线

```
PB3 (CLK) ─── W25Q64 (8MB Flash)
PB4 (DI)  ─── W25Q 数据输入 (MCU→Flash)
PB5 (DO)  ─── W25Q 数据输出 (Flash→MCU)
PA15 (CS) ─── W25Q 片选
```

> 软件SPI (Mode 0)，关中断保护时序，~1MHz时钟速率
