daobaitou/STM32_SmartFarm/文档/智能农业监测系统_技术方案.md

# 基于STM32智能农业监测与灌溉控制系统 — 完整技术方案

> 文档生成时间：2024年3月
> 适用对象：物联网工程专业本科毕业设计

---

## 一、硬件方案设计

### 1.1 主控芯片

| 方案 | 说明 |
|---|---|
| **STM32F103C8T6**（推荐） | 成本低（~10元），资源够用，资料最多，适合毕设 |

> F103C8T6：64KB Flash + 20KB RAM，跑 FreeRTOS + MQTT 完全没问题。

### 1.2 环境监测传感器

| 传感器 | 型号 | 接口 | 说明 |
|---|---|---|---|
| 空气温湿度 | **DHT22（AM2302）** | 单总线 | 精度 ±0.5°C / ±2%RH |
| 土壤湿度 | **FC28** 或电容式 | ADC | 模拟量输出 |
| 土壤温度 | **DS18B20防水** | 单总线 | 防水探头，精度±0.5°C |
| 光照强度 | **BH1750** | I2C | 数字输出，稳定可靠 |
| CO2浓度 | **MH-Z19B** | UART | 串口输出，精度±50ppm |
| 大气压强 | **BMP180** | I2C | 气压+海拔，300-1100hPa |
| 雨滴检测 | **LM393雨滴模块** | ADC/DO | 检测是否下雨 |

### 1.3 灌溉系统模块

| 模块 | 型号 | 接口 | 说明 |
|---|---|---|---|
| 水流传感器 | **YF-S201** | 脉冲计数 | 测量灌溉用水量 |
| 水位传感器 | **水滴检测板** | ADC | 监测水箱水位 |
| 继电器模块 | **5V继电器+光耦** | GPIO | 控制水泵启停 |
| 水泵 | **12V直流水泵** | 继电器驱动 | 执行灌溉 |

### 1.4 人机交互模块

| 模块 | 型号 | 接口 | 说明 |
|---|---|---|---|
| 显示模块 | **0.96寸OLED（SSD1306）** | I2C | 128x64分辨率 |
| 报警模块 | **蜂鸣器 + LED** | GPIO | 声光报警 |
| RTC时钟 | **DS3231** | I2C | 精确时间戳，断电保持 |
| 按键模块 | **4个轻触按键** | GPIO | 本地控制/设置 |

### 1.5 通信模块

| 模块 | 型号 | 接口 | 说明 |
|---|---|---|---|
| WiFi模块 | **ESP8266（ESP-12E NodeMCU）** | UART | 独立运行Arduino固件，处理WiFi+MQTT+JSON |

> **v4.0架构变更**：实际开发中使用ESP-12E NodeMCU开发板（而非ESP-01S），ESP8266独立运行Arduino固件处理WiFi+MQTT+JSON，STM32通过UART文本协议与其通信，各司其职。

### 1.6 电源系统设计（市电+电池备用）

本系统采用**双电源供电架构**，以市电为主电源，锂电池为备用电源，实现断电自动切换和低功耗备用模式。

#### 1.6.1 电源架构图

```
┌─────────────────────────────────────────────────────────────────┐
│                      双电源供电系统                              │
│                                                                 │
│   ┌──────────┐                           ┌──────────┐          │
│   │ 12V电源  │                           │ 锂电池   │          │
│   │ 适配器   │                           │ 7.4V     │          │
│   │ (市电)   │                           │ 18650x2  │          │
│   └────┬─────┘                           └────┬─────┘          │
│        │                                      │                │
│        ▼                                      ▼                │
│   ┌──────────┐                           ┌──────────┐          │
│   │ 降压模块  │                           │ 升压模块  │          │
│   │ LM2596   │                           │ MT3608   │          │
│   │ 12V→5V   │                           │ 7.4V→5V  │          │
│   └────┬─────┘                           └────┬─────┘          │
│        │                                      │                │
│        │      ┌───────────────────┐          │                │
│        └─────►│  二极管OR切换电路  │◄─────────┘                │
│               │  (市电优先)        │                           │
│               └─────────┬─────────┘                           │
│                         │                                     │
│                         ▼                                     │
│                ┌─────────────────┐                            │
│                │   5V系统总线    │──► 传感器 + ESP8266        │
│                │                 │──► OLED + 继电器           │
│                └────────┬────────┘                            │
│                         │                                     │
│                         ▼                                     │
│                ┌─────────────────┐                            │
│                │ 3.3V LDO (板载) │──► STM32主控               │
│                └─────────────────┘                            │
│                                                                 │
│   ┌────────────────────────────────────────────────────────┐   │
│   │ 12V ──► 电阻分压 ──► STM32 GPIO (断电检测)             │   │
│   │        (R1=10k, R2=3.3k)                               │   │
│   └────────────────────────────────────────────────────────┘   │
│                                                                 │
│   水泵独立供电：12V DC（直接取自市电适配器）                    │
└─────────────────────────────────────────────────────────────────┘
```

#### 1.6.2 电源切换逻辑

| 状态 | 供电来源 | 系统模式 | 采集周期 | OLED | MQTT心跳 |
|---|---|---|---|---|---|
| **正常** | 市电 | 全功能 | 2秒 | 常亮 | 10秒 |
| **断电** | 电池 | 备用低功耗 | 30秒 | 关闭 | 60秒 |
| **恢复** | 市电 | 全功能 | 2秒 | 恢复 | 10秒 |

#### 1.6.3 断电检测与响应

```
断电检测电路：
  12V市电 ──┬──► LM2596 ──► 5V系统
            │
            └──► R1(10k) ──┬──► STM32 GPIO (PA0)
                           │
                           R2(3.3k)
                           │
                           GND

  当12V消失时，GPIO电平从高变低，触发外部中断
```

**软件响应流程**：
```
GPIO中断触发
    ↓
判断电平变化
    ├─ 低电平（断电）→ 进入备用模式
    │                  - 采集周期改为30秒
    │                  - 关闭OLED显示
    │                  - MQTT心跳延长到60秒
    │                  - 发送断电告警到云端
    │
    └─ 高电平（恢复）→ 恢复正常模式
                       - 采集周期恢复2秒
                       - 打开OLED显示
                       - MQTT心跳恢复10秒
                       - 发送恢复通知
```

#### 1.6.4 水泵供电说明

- 水泵使用12V独立供电（直接取自市电适配器）
- 断电时水泵无法工作（符合安全逻辑：断电不灌溉）
- 继电器控制信号来自STM32（3.3V逻辑电平）

### 1.7 硬件清单

| 序号 | 类别 | 模块名称 | 型号/规格 | 数量 | 接口 | 单价（元） | 在系统中的应用 |
|:----:|---|---|---|:----:|---|:---:|---|
| 1 | **主控** | 微控制器最小系统板 | STM32F103C8T6 | 1 | — | 10 | 系统核心，运行FreeRTOS多任务调度，协调传感器采集、通信、灌溉控制和本地显示等所有功能 |
| 2 | **通信** | WiFi通信模块 | ESP8266 ESP-01S | 1 | UART | 15 | 通过UART与STM32通信，连接WiFi网络，使用MQTT协议实现数据上传和命令接收 |
| 3 | **环境监测** | 空气温湿度传感器 | DHT22（AM2302） | 1 | 单总线 | 12 | 采集空气温度和湿度，精度±0.5°C / ±2%RH，用于环境监测和异常报警 |
| 4 | | 土壤湿度传感器 | FC28 | 1 | ADC | 5 | 采集土壤湿度模拟量，自动灌溉的核心判断依据 |
| 5 | | 土壤温度传感器 | DS18B20（防水） | 1 | 单总线 | 8 | 采集土壤温度，与土壤湿度配对形成完整土壤参数监测 |
| 6 | | 光照强度传感器 | BH1750 | 1 | I2C | 8 | 采集环境光照强度（lux），用于判断天气状况和作物光照需求 |
| 7 | | CO2浓度传感器 | MH-Z19B | 1 | UART | 80 | 采集二氧化碳浓度（ppm），监测温室通风状况 |
| 8 | | 大气压强传感器 | BMP180 | 1 | I2C | 8 | 采集大气压强，与温湿度组成完整气象参数 |
| 9 | | 雨滴检测模块 | LM393 | 1 | ADC | 5 | 检测是否降雨，配合天气API实现双重降雨判断，雨天自动暂停灌溉 |
| 10 | **灌溉系统** | 水流传感器 | YF-S201 | 1 | 脉冲计数 | 8 | 测量灌溉用水量（L/min），统计每次灌溉和累计用水量，体现节水效果 |
| 11 | | 水位传感器 | 水滴水位模块 | 1 | ADC | 5 | 监测水箱水位，低水位时触发报警并禁止启动水泵，防止干烧 |
| 12 | | 继电器模块 | 5V光耦隔离 | 1 | GPIO | 5 | 接收STM32控制信号，驱动12V水泵的通断，实现自动/手动灌溉 |
| 13 | | 直流水泵 | 12V微型 | 1 | — | 15 | 灌溉执行机构，由继电器控制启停，市电供电时可用 |
| 14 | **人机交互** | OLED显示屏 | 0.96寸 SSD1306 | 1 | I2C | 10 | 本地显示实时传感器数据、系统状态和报警信息，现场监控 |
| 15 | | 实时时钟模块 | DS3231 | 1 | I2C | 10 | 提供精确时间戳（年月日时分秒），断电不丢失，用于数据记录和定时任务 |
| 16 | | 蜂鸣器 | 有源蜂鸣器 | 1 | GPIO | 2 | 报警时发出声音提示，配合LED实现声光报警 |
| 17 | | LED指示灯 | 红绿LED | 2 | GPIO | 1 | 红灯：报警/故障；绿灯：系统正常运行 |
| 18 | | 轻触按键 | 6x6x5mm | 4 | GPIO | 2 | 本地手动控制（切换模式、启停水泵、切换显示页面、消音报警） |
| 19 | **电源系统** | 电源适配器 | 12V/2A | 1 | — | 10 | 主电源，为系统提供稳定的12V市电供电 |
| 20 | | 降压模块 | LM2596（可调） | 1 | — | 5 | 将市电12V降压至5V，为传感器、ESP8266、OLED等5V设备供电 |
| 21 | | 备用锂电池 | 18650 × 2（串联7.4V） | 2 | — | 15 | 备用电源，市电断开时为系统供电，保障系统连续运行 |
| 22 | | 电池盒 | 18650双节带引线 | 1 | — | 3 | 固定两节18650电池，提供7.4V输出接口 |
| 23 | | 升压模块 | MT3608 | 1 | — | 3 | 将电池7.4V升压至5V，与市电5V并联作为系统备用供电 |
| 24 | | 整流二极管 | 1N5822（肖特基） | 2 | — | 2 | 组成二极管OR电路，实现市电优先、电池备用的自动切换 |
| 25 | | 滤波电容 | 470μF电解电容 | 1 | — | 2 | 水泵启动瞬间滤波，防止电压骤降导致系统复位 |
| 26 | **配件** | 面包板 | 830孔全尺寸 | 1 | — | 8 | 硬件原型搭建，无需焊接，方便调试和修改电路 |
| 27 | | 杜邦线套装 | 公对母/公对公 | 1套 | — | 5 | 连接各模块与面包板 |
| 28 | | USB转TTL | CH340模块 | 1 | — | 8 | STM32程序烧录和串口调试 |
| 29 | | 排针排母 | 2.54mm间距 | 若干 | — | 2 | ESP-01S转接板引脚扩展 |
| | | | | | **总计** | **约271元** | |

### 1.8 硬件成本汇总

| 类别 | 件数 | 小计（元） | 占比 |
|---|:----:|:---:|:----:|
| 主控 | 1 | 10 | 3.7% |
| 通信 | 1 | 15 | 5.5% |
| 环境监测 | 7 | 126 | 46.5% |
| 灌溉系统 | 4 | 33 | 12.2% |
| 人机交互 | 5 | 25 | 9.2% |
| 电源系统 | 7 | 40 | 14.8% |
| 配件 | 4 | 22 | 8.1% |
| **合计** | **29** | **271** | **100%** |

---

## 二、软件架构设计（FreeRTOS）

### 2.1 任务划分

```
优先级  | 任务名称           | 堆栈 | 功能
--------|-------------------|------|------------------
6(最高) | Task_Alarm        | 256B | 报警判断 + 声光控制 + 断电检测响应
5       | Task_MQTT_Sub     | 512B | MQTT订阅 + 接收命令
4       | Task_Irrigation   | 512B | 灌溉逻辑 + 水流统计
3       | Task_WaterLevel   | 256B | 水位监测 + 低水位报警
2       | Task_Sensor       | 768B | 环境传感器采集(7个)
2       | Task_Rain         | 256B | 雨滴检测 + 中断处理
2       | Task_LCD          | 512B | OLED数据显示
2       | Task_Key          | 256B | 按键扫描 + 本地控制
1(最低) | Task_MQTT_Pub     | 512B | MQTT数据上传
```

### 2.2 消息队列设计

```
sensor_data_queue:  Task_Sensor → Task_LCD + Task_MQTT_Pub
control_cmd_queue:  Task_MQTT_Sub → Task_Irrigation
alarm_data_queue:   Task_Sensor/Task_WaterLevel → Task_Alarm
rain_event_queue:   Task_Rain → Task_Irrigation (下雨暂停灌溉)
```

### 2.3 采集策略

| 传感器 | 采集周期 | 说明 |
|---|---|---|
| DHT22 | 2秒 | 空气温湿度 |
| DS18B20 | 2秒 | 土壤温度 |
| FC28 | 1秒 | 土壤湿度(ADC) |
| BH1750 | 1秒 | 光照强度 |
| MH-Z19B | 5秒 | CO2浓度(UART) |
| BMP180 | 2秒 | 大气压强 |
| YF-S201 | 实时 | 水流脉冲计数(中断) |
| 水位 | 1秒 | ADC读取 |
| 雨滴 | 实时 | 中断触发 |

---

## 三、通信协议设计

### 3.1 MQTT Topic

```
# 上行
smartfarm/{device_id}/sensor/data      # 传感器数据
smartfarm/{device_id}/status/report    # 设备状态

# 下行
smartfarm/{device_id}/control/mode     # 模式切换
smartfarm/{device_id}/control/pump     # 水泵控制
smartfarm/{device_id}/config/threshold # 阈值设置
```

### 3.2 JSON数据格式

**传感器数据：**
```json
{
  "device_id": "farm_001",
  "timestamp": 1711234567,
  "data": {
    "temperature": 25.6,
    "humidity": 65.2,
    "soil_moisture": 42,
    "soil_temperature": 22.1,
    "light": 850,
    "co2": 420,
    "pressure": 1013.2,
    "raindrop": 0,
    "water_flow": 0.5,
    "water_level": 75
  }
}
```

**控制命令：**
```json
{
  "device_id": "farm_001",
  "command": "pump",
  "action": "on",
  "timestamp": 1711234567
}
```

### 3.3 QoS选择

- 传感器数据：QoS 0
- 控制命令：QoS 1

### 3.4 云服务器部署方案

本系统采用**自有的腾讯云服务器**部署MQTT Broker和Web服务端，实现私有化部署，数据安全可控。

> **实际部署**：MQTT Broker（Mosquitto）已部署在 124.223.5.91:1883，支持匿名连接。ESP8266通过WiFi连接到该Broker，实现数据上报和命令接收。

**服务器配置要求**：
- 操作系统：Ubuntu 20.04 / 22.04 LTS
- CPU：1核及以上
- 内存：1GB及以上
- 存储：20GB及以上
- 网络：公网IP，开放1883、5000端口

**部署服务清单**：

| 服务 | 软件 | 端口 | 说明 |
|---|---|---|---|
| MQTT Broker | **Mosquitto** | 1883 | 轻量级消息代理，处理设备通信 |
| Web服务端 | **Flask + Gunicorn** | 5000 | 提供API和Web页面 |
| 数据库 | **SQLite** | - | 文件型数据库，无需额外部署 |
| 进程管理 | **systemd** | - | 开机自启和进程守护 |

**私有化部署优势**：
1. 数据存储在自有服务器，安全性更高
2. 无依赖第三方服务，系统稳定性可控
3. 可根据需求扩展功能（如增加用户认证、数据备份等）
4. 答辩时体现完整的云端部署能力

---

## 四、QT上位机设计

### 4.1 界面架构

```
页面1: 实时监控主页
  - 传感器数据卡片
  - 异常值标红
  - 灌溉状态面板
  - 设备在线状态

页面2: 灌溉控制页
  - 模式切换（自动/手动）
  - 手动控制面板
  - 阈值设置
  - 灌溉日志

页面3: 历史数据页
  - 时间范围选择
  - QChart折线图
  - 数据导出（CSV）

页面4: 系统设置页
  - MQTT配置
  - 阈值配置
```

### 4.2 SQLite数据表

```sql
CREATE TABLE sensor_data (
    id INTEGER PRIMARY KEY AUTOINCREMENT,
    timestamp DATETIME DEFAULT CURRENT_TIMESTAMP,
    temperature REAL,        -- 空气温度(°C)
    humidity REAL,           -- 空气湿度(%)
    soil_moisture REAL,      -- 土壤湿度(%)
    soil_temperature REAL,   -- 土壤温度(°C)
    light REAL,              -- 光照强度(lux)
    co2 REAL,                -- CO2浓度(ppm)
    pressure REAL,           -- 大气压强(hPa)
    raindrop INTEGER,        -- 雨滴状态(0/1)
    water_flow REAL,         -- 水流量(L)
    water_level INTEGER      -- 水位(%)
);

CREATE TABLE irrigation_log (
    id INTEGER PRIMARY KEY AUTOINCREMENT,
    timestamp DATETIME DEFAULT CURRENT_TIMESTAMP,
    mode TEXT,               -- 'auto' or 'manual'
    action TEXT,             -- 'on' or 'off'
    duration INTEGER,        -- 灌溉时长(秒)
    water_used REAL,         -- 用水量(升)
    soil_before REAL,        -- 灌溉前土壤湿度
    soil_after REAL          -- 灌溉后土壤湿度
);
```

---

## 五、新增功能设计

### 5.1 天气数据联动

- API：和风天气（1000次/天免费）
- 功能：降雨概率 > 70% 时跳过灌溉

### 5.2 数据导出与报表

- CSV导出
- 日报/周报生成

### 5.3 Web端（部署至腾讯云服务器）

**服务端架构**：
```
腾讯云服务器
├── Mosquitto (MQTT Broker, 端口1883)
├── Flask + Gunicorn (Web服务, 端口5000)
├── SQLite (数据存储)
└── systemd (进程守护 + 开机自启)
```

**部署步骤**：

```bash
# 1. 连接服务器
ssh root@你的服务器公网IP

# 2. 安装环境
apt update && apt install -y python3 python3-pip mosquitto
pip3 install flask paho-mqtt gunicorn

# 3. 启动Mosquitto
systemctl start mosquitto
systemctl enable mosquitto

# 4. 部署Flask应用（详见附录）
# 5. 配置防火墙开放1883、5000端口
# 6. 配置systemd实现开机自启
```

**访问方式**：
- Web页面：`http://你的服务器IP:5000`
- MQTT地址：`你的服务器IP:1883`

**优势**：私有化部署，数据安全可控，体现完整云端能力

### 5.4 断电恢复

- STM32 Flash存储配置
- 上电自动恢复

---

## 六、6周实施计划

| 周次 | 任务 | 检查点 |
|---|---|---|
| 第1周 | 硬件采购 + 开发环境 + 传感器驱动 | 串口打印传感器数据 |
| 第2周 | FreeRTOS移植 + ESP8266 MQTT | WiFi连接 + MQTT通信 |
| 第3周 | 灌溉控制 + OLED显示 + 报警 | 自动灌溉触发 |
| 第4周 | QT上位机核心功能 | QT显示MQTT数据 |
| 第5周 | QT高级功能 + 天气API | 历史曲线 + 天气信息 |
| 第6周 | Web端部署 + 云服务器配置 + 断电恢复 + 联调 | 手机通过公网访问Web页面 |

---

## 七、开题报告内容

### 1、毕业设计（论文）的主要内容

本课题设计并实现一套基于STM32的智能农业监测与灌溉控制系统，涵盖嵌入式终端、云端通信和远程上位机三个层面。主要研究内容如下：

**（1）硬件系统设计**

以STM32F103C8T6微控制器为核心，设计多传感器环境参数采集模块，包括DHT22空气温湿度传感器、FC28土壤湿度传感器、DS18B20土壤温度传感器、BH1750光照强度传感器、MH-Z19B二氧化碳浓度传感器、BMP180大气压强传感器和LM393雨滴检测模块。灌溉系统方面采用YF-S201水流传感器测量灌溉用水量，配合水位传感器监测水箱水位防止干烧。通信方面采用ESP8266 WiFi模块通过UART与主控通信，接入MQTT协议实现设备上云。此外设计了继电器驱动模块控制水泵执行灌溉动作，OLED显示模块和蜂鸣器报警模块用于现场人机交互，DS3231 RTC模块提供精确时间戳，轻触按键支持本地手动控制。**电源系统采用市电+电池双电源架构，实现断电自动切换和低功耗备用模式，保障系统供电可靠性。**

**（2）嵌入式软件设计**

基于FreeRTOS嵌入式实时操作系统进行多任务软件开发，设计传感器采集、MQTT通信、灌溉控制、LCD显示、报警判断和电源管理等多个并发任务，通过消息队列和信号量实现任务间数据共享与同步。**设计双电源供电管理机制，通过GPIO中断检测市电状态，断电时自动切换到电池备用并进入低功耗模式，降低采集频率、关闭非必要外设以延长续航时间。**同时设计断网数据缓存机制和断电参数恢复功能，保证系统在通信中断和供电异常情况下的可靠性。

**（3）远程监控平台设计**

开发基于QT框架的桌面端上位机软件，实现传感器数据的实时展示、多参数历史曲线绘制、自动/手动灌溉模式切换和报警阈值配置等功能。同时基于Flask框架开发轻量级Web服务端，支持通过手机浏览器远程访问系统数据和发送控制指令。

**（4）智能决策功能**

集成第三方天气数据服务接口，根据天气预报信息（降雨概率、温度趋势）智能调整灌溉策略，实现基于环境综合信息的决策型灌溉控制，提升系统的智能化水平。

---

### 2、设计（论文）的技术路线及预期目标

**技术路线：**

本系统采用"端-边-云"三层架构，具体技术路线如下：

```
                              ┌──────────────────────────────────┐
                              │         用户访问层               │
                              │  ┌────────┐ ┌────────┐ ┌────────┐│
                              │  │PC电脑  │ │手机    │ │平板    ││
                              │  │QT上位机│ │浏览器  │ │浏览器  ││
                              │  └───┬────┘ └───┬────┘ └───┬────┘│
                              └──────┼──────────┼──────────┼─────┘
                                     │ MQTT     │ HTTP     │ HTTP
                                     ▼          ▼          ▼
┌────────────────────────────────────────────────────────────────────────┐
│                              云端（腾讯云服务器）                        │
│  ┌──────────────────────────────────────────────────────────────────┐  │
│  │                     Mosquitto MQTT Broker                        │  │
│  │                       消息路由与转发中心                           │  │
│  └───────────────────────────────┬──────────────────────────────────┘  │
│                                  │                                      │
│  ┌────────────┐  ┌────────────┐  │  ┌────────────┐  ┌────────────┐    │
│  │ Flask Web  │  │  SQLite    │  │  │  systemd   │  │  和风天气  │    │
│  │ REST API   │  │  数据库    │  │  │  进程管理  │  │  API接口   │    │
│  └────────────┘  └────────────┘  │  └────────────┘  └────────────┘    │
└──────────────────────────────────┼─────────────────────────────────────┘
                                   │
                                   │ WiFi + MQTT over TCP
                                   │
┌──────────────────────────────────┼─────────────────────────────────────┐
│                            传输层 │                                     │
│  ┌───────────────────────────────┴──────────────────────────────────┐  │
│  │                        ESP8266 WiFi模块                           │  │
│  │  • WiFi网络连接        • MQTT协议发布/订阅                       │  │
│  │  • UART串口通信(115200) • JSON数据格式                           │  │
│  └───────────────────────────────┬──────────────────────────────────┘  │
└──────────────────────────────────┼─────────────────────────────────────┘
                                   │ UART
                                   ▼
┌────────────────────────────────────────────────────────────────────────┐
│                        感知层（嵌入式终端）                              │
│  ┌──────────────────────────────────────────────────────────────────┐  │
│  │                    STM32F103C8T6 + FreeRTOS                       │  │
│  │  多任务调度：传感器采集 | 灌溉控制 | 通信管理 | 界面显示 | 报警  │  │
│  └──────────────────────────────────────────────────────────────────┘  │
│                                                                         │
│  ┌─── 环境监测模块 ───┐  ┌─── 灌溉系统模块 ───┐  ┌─── 人机交互模块 ───┐│
│  │ DHT22   空气温湿度 │  │ YF-S201  水流计量 │  │ OLED     本地显示  ││
│  │ FC28    土壤湿度   │  │ 水位传感器 水位   │  │ 蜂鸣器   声音报警  ││
│  │ DS18B20 土壤温度   │  │ 继电器   水泵控制 │  │ LED      状态指示  ││
│  │ BH1750  光照强度   │  └───────────────────┘  │ DS3231   RTC时钟   ││
│  │ MH-Z19B CO2浓度    │                         │ 按键     本地控制  ││
│  │ BMP180  大气压强   │  ┌─── 电源系统模块 ───┐  └───────────────────┘│
│  │ LM393   雨滴检测   │  │ 市电12V  主电源    │                        │
│  └───────────────────┘  │ 电池7.4V 备用电源  │                        │
│                          │ 自动切换  断电检测  │                        │
│                          └───────────────────┘                        │
└────────────────────────────────────────────────────────────────────────┘
```

**数据流向说明**：

| 流向 | 路径 | 说明 |
|---|---|---|
| **上行数据** | 传感器 → FreeRTOS队列 → MQTT发布 → 云端 → 上位机显示 | 环境数据实时上报 |
| **下行控制** | 上位机 → 云端MQTT → STM32订阅 → 执行器动作 | 远程灌溉控制 |
| **智能决策** | 天气API → 降雨分析 → 策略下发 → 本地执行 | 智能灌溉调度 |
| **断电响应** | 市电检测 → GPIO中断 → 切换备用模式 | 供电连续性保障 |

感知层以STM32F103C8T6为主控，在FreeRTOS操作系统上运行传感器采集、灌溉控制和本地显示等任务。STM32通过USART2以UART文本协议与ESP8266通信，ESP8266独立运行Arduino固件处理WiFi连接和MQTT协议，将数据上传至腾讯云服务器上的Mosquitto消息代理，同时接收来自上位机的控制命令并转发给STM32。这种双MCU架构使STM32专注实时采集，ESP8266专注网络通信，各司其职。

应用层分为两个部分：QT桌面端提供完整的监控管理界面，包括实时数据展示、历史曲线、灌溉控制和数据导出等功能；Flask Web端部署在腾讯云服务器上，提供移动端访问入口，通过REST API和MQTT桥接实现与设备端的间接通信，支持手机浏览器远程访问。

数据存储采用双端方案：STM32端利用内部Flash存储系统配置和断网缓存数据，保障数据安全；腾讯云服务器端采用SQLite数据库存储历史传感器数据和灌溉日志，支持数据查询、图表展示和报表导出。

**预期目标：**

1. 实现多传感器环境参数（温度、湿度、土壤温湿度、光照强度、CO2浓度、大气压强、降雨检测）的实时采集与本地OLED显示
2. 实现灌溉用水量统计和水箱水位监测，低水位自动报警，防止干烧
3. 基于MQTT协议实现嵌入式终端与远程上位机的双向通信，通过腾讯云服务器部署私有化MQTT Broker，通信延迟不超过2秒
4. 实现自动灌溉和手动灌溉两种控制模式，支持降雨检测自动暂停灌溉，土壤湿度达标自动关闭水泵
5. QT上位机实现实时监控、多参数历史曲线、灌溉控制、数据导出和报表生成等完整功能
6. 开发Web端页面部署至腾讯云服务器，支持手机浏览器远程访问
7. 集成天气数据服务，结合本地雨滴检测实现双重降雨判断，智能调整灌溉策略
8. 系统具备双电源供电能力，市电优先、电池备用，断电自动切换到低功耗模式，保障系统连续运行
9. 系统具备断电参数恢复和断网数据缓存能力，关键数据持久化存储

---

### 3、课题进度计划

| 阶段 | 时间 | 主要工作内容 |
|---|---|---|
| 第一阶段 | 第1-2周 | 需求分析与方案设计，硬件采购，搭建STM32开发环境，完成传感器驱动调试 |
| 第二阶段 | 第3-4周 | FreeRTOS移植与多任务开发，ESP8266 MQTT通信联调，灌溉控制逻辑实现，本地OLED显示与报警功能 |
| 第三阶段 | 第5-6周 | QT上位机开发：实时监控界面、灌溉控制、历史曲线、SQLite数据存储 |
| 第四阶段 | 第7-8周 | QT高级功能：天气API对接、数据导出与报表生成；Flask Web端开发；腾讯云服务器环境配置与服务部署 |
| 第五阶段 | 第9周 | STM32端断电恢复功能开发，系统整体联调与功能测试，云服务器公网访问验证 |
| 第六阶段 | 第10-12周 | 撰写毕业论文，制作答辩PPT，录制系统演示视频，准备答辩 |

---

### 4、参考文献、资料

#### 综述与背景类（绪论引用）

[1] 赵春江. 智慧农业的发展现状与未来展望[J]. 华南农业大学学报, 2021, 42(6): 1-11.
> **可引用内容**："智慧农业是我国农业现代化的重要方向。物联网、传感器、智能识别、大数据分析等技术在智慧农业中的应用，可以实现农业生产的远程监控、智能化决策、精准化管理。"

[2] 李道亮. 农业物联网技术发展现状及趋势[J]. 中国科学院院刊, 2023, 38(8): 1021-1030.
> **可引用内容**："物联网技术通过感知层、传输层和应用层的协同工作，实现农业生产环境的实时监测与智能控制。"

[3] Al-Fuqaha A, Guizani M, Mohammadi M, et al. Internet of Things: A survey on enabling technologies, protocols, and applications[J]. IEEE Communications Surveys & Tutorials, 2015, 17(4): 2347-2376.
> **可引用内容**："The IoT paradigm enables seamless integration of physical objects into the information world, facilitating remote monitoring and control of agricultural environments."

#### STM32与智能灌溉类（硬件设计引用）

[4] 王永涛, 李建军, 张明. 基于STM32的智能灌溉控制系统设计[J]. 农机化研究, 2022, 44(10): 166-170.
> **可引用内容**："针对灌溉过程中存在的自动化程度低等问题，设计了一种以STM32为主控制芯片的智能灌溉控制系统，采用模糊控制算法作为主控制算法。"

[5] 刘志强, 周华英. 基于STM32和树莓派智能灌溉系统的设计与实现[J]. 物联网技术, 2021, 11(7): 95-98.
> **可引用内容**："系统由STM32单片机、土壤干湿度传感器、树莓派、串口蓝牙模块等组成，实现了智能检测种植物类型并提供科学提示及灌溉方案。"

[6] 董天慧, 王晶, 王佳铭, 等. 基于STM32的多功能智能灌溉系统设计[J]. 长治学院学报, 2024, 41(2): 45-50.

#### FreeRTOS嵌入式系统类（软件设计引用）

[7] 熊一鹏, 岳伟. FreeRTOS多任务调度机制在监控单元中的应用[J]. 单片机与嵌入式系统应用, 2021, 21(9): 64-66.
> **可引用内容**："设计了基于FreeRTOS系统多任务调度机制的监控单元，通过消息队列和信号量实现任务间数据共享与同步。"

[8] 魏杰, 尹力, 曹晋豪, 等. 基于FreeRTOS优化的嵌入式实时操作系统设计[J]. 软件导刊, 2022, 21(3): 45-48.
> **可引用内容**："FreeRTOS作为开源的实时操作系统，具有内核小巧、响应速度快、资源占用少等优点，适合在资源受限的嵌入式设备上运行。"

#### MQTT物联网通信类（通信设计引用）

[9] 张伟, 李明. 基于MQTT协议的物联网云平台设计与实现[J]. 电子技术应用, 2023, 49(3): 112-116.
> **可引用内容**："构建了基于MQTT协议的物联网云平台，具备设备接入、设备控制、账号管理、安全管理等基础能力，通过建立通用的标准通信协议，提供标准的设备接入及客户端访问接口。"

[10] 陈刚, 王磊. 基于MQTT的物联网网关双向通信系统设计[J]. 计算机工程与设计, 2022, 43(5): 1345-1350.
> **可引用内容**："针对IoT网络体系复杂和协议不标准化问题，设计基于MQTT的网关双向通信系统，采用发布/订阅模式实现设备与云端的异步通信。"

#### ESP8266与远程监控类（通信模块引用）

[11] 孙九, 李华. 基于STM32和ESP8266的远程环境监测系统设计[J]. 传感器与微系统, 2022, 41(6): 89-92.
> **可引用内容**："以STM32为主控芯片，结合ESP8266网络芯片，构建出一个可扩展的物联网设备系统，实现了将硬件产生的数据通过WiFi统一上传至云端。"

[12] 赵明, 周杰. 基于STM32与ESP8266驱动的智能大棚环境监测控制系统设计与试验[J]. 传感器与微系统, 2024, 43(1): 105-109.
> **可引用内容**："通过研发基于STM32微控制器和ESP8266模块的智能大棚环境监测控制系统，实现数字化和智能化的农业生产管理。"

#### QT上位机类（应用层设计引用）

[13] 陈六, 赵七. 基于Qt的农业监测上位机系统设计与实现[J]. 计算机测量与控制, 2022, 30(8): 201-205.
> **可引用内容**："为解决数据存储不便、控制距离不远、数据显示不直观等问题，基于Qt设计上位机软件，利用串口采集温度、湿度等数据，通过数据库对数据进行分类存储与管理。"

[14] 李强, 张华. 基于Qt的水质多参数监测软件研究[J]. 环境工程学报, 2019, 13(5): 1120-1126.
> **可引用内容**："采用无线通信方式与物联网相结合，使用ZigBee实现数据传输，结合MySQL数据库和云端服务器，实现了多参数的读取、查询和预警功能。"

#### 智能决策与天气联动类（智能功能引用）

[15] 杨十一, 王强. 基于天气数据的智能灌溉决策算法研究[J]. 排灌机械工程学报, 2022, 40(4): 385-390.
> **可引用内容**："根据天气预报信息（降雨概率、温度趋势）智能调整灌溉策略，当未来6小时内降雨概率超过70%时，系统自动跳过本次灌溉，实现节水增效。"

#### 技术标准与官方文档

[16] AM2302 (DHT22) Humidity & Temperature Sensor Datasheet[S]. Aosong Electronics, 2020.

[17] ESP8266 AT Instruction Set[S]. Espressif Systems, 2021.

[18] FreeRTOS Official Documentation[EB/OL]. https://www.freertos.org/, 2023.

[19] MQTT Version 5.0 Specification[EB/OL]. OASIS Standard, 2019.

[20] Qt 6 Documentation[EB/OL]. https://doc.qt.io/, 2024.

> **使用说明**：
> - 绪论部分引用 [1]-[3]，说明智慧农业和物联网的背景
> - 硬件设计引用 [4]-[6]，说明STM32智能灌溉的技术基础
> - 软件设计引用 [7]-[8]，说明FreeRTOS的优势
> - 通信设计引用 [9]-[12]，说明MQTT和ESP8266的适用性
> - 上位机设计引用 [13]-[14]，说明QT的跨平台优势
> - 智能功能引用 [15]，说明天气联动的理论依据
> - 技术标准 [16]-[20] 可在各章节引用传感器/模块参数时使用

### 5、完成课题所需条件及落实措施

**（1）硬件条件**

本系统所需硬件主要包括：STM32F103C8T6最小系统板、ESP8266 WiFi模块、DHT22空气温湿度传感器、FC28土壤湿度传感器、DS18B20土壤温度传感器、BH1750光照传感器、MH-Z19B二氧化碳传感器、BMP180大气压强传感器、LM393雨滴检测模块、YF-S201水流传感器、水位传感器、0.96寸OLED显示屏、DS3231 RTC时钟模块、5V继电器模块、12V直流水泵、蜂鸣器及LED报警模块、轻触按键、杜邦线和面包板等。**电源系统采用12V适配器（市电）+18650锂电池（备用）双电源架构，配合LM2596降压模块和MT3608升压模块实现自动切换。**上述硬件均可通过淘宝等电商平台采购，总成本约为270元。此外需要一台个人计算机用于软件开发和程序烧录，以及自有的腾讯云服务器用于部署MQTT Broker和Web服务端。

**（2）软件条件**

嵌入式开发方面，使用Keil MDK或STM32CubeIDE作为STM32开发环境，采用C语言编写嵌入式程序，FreeRTOS操作系统源码可从官网免费获取。上位机开发方面，使用Qt Creator集成开发环境和Qt框架（开源版本）开发桌面端监控软件，数据库采用SQLite。Web端开发使用Python语言和Flask框架。上述开发工具均为免费或开源软件。

**（3）网络与平台条件**

系统采用**自有的腾讯云服务器**作为云端平台，实现私有化部署。服务器配置为Ubuntu操作系统，部署Mosquitto作为MQTT消息代理服务器，部署Flask作为Web服务端，数据库采用SQLite。相比使用公共MQTT服务器，私有化部署具有以下优势：数据存储在自有服务器，安全性更高；无依赖第三方服务，系统稳定性可控；可根据需求灵活扩展功能。天气数据接口使用和风天气提供的免费API（每日1000次调用额度），满足系统智能决策需求。

**（4）知识储备条件**

本人在大学期间已系统学习了单片机原理与应用、嵌入式系统设计、C语言程序设计、计算机网络、物联网技术等专业课程，掌握了STM32微控制器的基本开发方法，具备C/C++和Python编程能力，对FreeRTOS实时操作系统和MQTT通信协议有一定了解，具备完成本课题的知识基础。

**（5）指导与资料条件**

在指导教师的指导下开展课题研究，遇到技术问题可及时沟通解决。参考文献主要来源于中国知网（CNKI）、万方数据等学术数据库，以及FreeRTOS官方文档、MQTT协议规范、Qt官方文档等开放技术资料。此外，CSDN、GitHub等开发者社区提供丰富的技术教程和开源项目可供参考。

---

## 八、腾讯云服务器部署指南

### 8.1 服务器环境配置

```bash
# 连接服务器
ssh root@你的服务器公网IP

# 更新系统
apt update && apt upgrade -y

# 安装必要软件
apt install -y python3 python3-pip python3-venv mosquitto mosquitto-clients nginx

# 安装Python依赖
pip3 install flask paho-mqtt gunicorn
```

### 8.2 Mosquitto MQTT Broker配置

```bash
# 启动Mosquitto服务
systemctl start mosquitto
systemctl enable mosquitto

# 验证服务状态
systemctl status mosquitto

# 测试MQTT（另开终端）
mosquitto_sub -h localhost -t "test/#"    # 订阅
mosquitto_pub -h localhost -t "test/hello" -m "Hello"  # 发布
```

### 8.3 Flask应用部署

**项目结构**：
```
/opt/smartfarm/
├── app.py              # Flask主程序
├── templates/
│   └── index.html      # Web页面
├── farm_data.db        # SQLite数据库（自动生成）
└── venv/               # Python虚拟环境
```

**app.py 核心代码**：
```python
from flask import Flask, render_template, jsonify, request
import sqlite3
import paho.mqtt.client as mqtt
import json
import threading
from datetime import datetime

app = Flask(__name__)
MQTT_BROKER = "localhost"
MQTT_PORT = 1883

def init_db():
    conn = sqlite3.connect('/opt/smartfarm/farm_data.db')
    conn.execute('''CREATE TABLE IF NOT EXISTS sensor_data (
        id INTEGER PRIMARY KEY AUTOINCREMENT,
        timestamp DATETIME DEFAULT CURRENT_TIMESTAMP,
        temperature REAL, humidity REAL, soil_moisture REAL,
        light REAL, co2 REAL
    )''')
    conn.commit()
    conn.close()

def on_message(client, userdata, msg):
    try:
        data = json.loads(msg.payload)
        conn = sqlite3.connect('/opt/smartfarm/farm_data.db')
        conn.execute('''INSERT INTO sensor_data
            (temperature, humidity, soil_moisture, light, co2)
            VALUES (?,?,?,?,?)''',
            (data['data']['temperature'], data['data']['humidity'],
             data['data']['soil_moisture'], data['data']['light'],
             data['data']['co2']))
        conn.commit()
        conn.close()
    except Exception as e:
        print(f"Error: {e}")

# MQTT客户端线程
mqtt_client = mqtt.Client()
mqtt_client.on_message = on_message
mqtt_client.connect(MQTT_BROKER, MQTT_PORT, 60)
mqtt_client.subscribe("smartfarm/+/sensor/data")
mqtt_thread = threading.Thread(target=mqtt_client.loop_forever)
mqtt_thread.daemon = True
mqtt_thread.start()

@app.route('/')
def index():
    return render_template('index.html')

@app.route('/api/latest')
def get_latest():
    conn = sqlite3.connect('/opt/smartfarm/farm_data.db')
    cursor = conn.execute("SELECT * FROM sensor_data ORDER BY timestamp DESC LIMIT 1")
    row = cursor.fetchone()
    conn.close()
    if row:
        return jsonify({
            "temperature": row[2], "humidity": row[3],
            "soil_moisture": row[4], "light": row[5],
            "co2": row[6], "timestamp": row[1]
        })
    return jsonify({"error": "no data"})

@app.route('/api/pump', methods=['POST'])
def control_pump():
    action = request.json.get('action')
    mqtt_client.publish("smartfarm/farm_001/control/pump",
                        json.dumps({"action": action, "timestamp": int(datetime.now().timestamp())}))
    return jsonify({"status": "ok", "action": action})

if __name__ == '__main__':
    init_db()
    app.run(host='0.0.0.0', port=5000, debug=False)
```

### 8.4 systemd服务配置（开机自启）

```bash
# 创建服务文件
cat > /etc/systemd/system/smartfarm.service << 'EOF'
[Unit]
Description=Smart Farm Web Service
After=network.target mosquitto.service

[Service]
Type=simple
WorkingDirectory=/opt/smartfarm
ExecStart=/usr/bin/python3 /opt/smartfarm/app.py
Restart=always
RestartSec=5
User=root

[Install]
WantedBy=multi-user.target
EOF

# 启用并启动服务
systemctl daemon-reload
systemctl enable smartfarm
systemctl start smartfarm
```

### 8.5 防火墙配置

```bash
# 开放端口
ufw allow 22      # SSH
ufw allow 1883    # MQTT
ufw allow 5000    # Flask Web
ufw enable

# 查看状态
ufw status
```

**腾讯云安全组配置**：
1. 登录腾讯云控制台
2. 进入云服务器 → 安全组
3. 添加入站规则：开放 TCP 1883、5000 端口

### 8.6 测试验证

```bash
# 测试MQTT连接
mosquitto_sub -h 你的服务器IP -t "smartfarm/#" -v

# 测试Web访问
curl http://你的服务器IP:5000/api/latest

# 手机浏览器访问
http://你的服务器IP:5000
```

### 8.7 端设备配置修改

**ESP8266端（config.h）**：
```cpp
#define WIFI_SSID     "KmustAuto"
#define WIFI_PASSWORD "123456789"
#define MQTT_BROKER   "124.223.5.91"
#define MQTT_PORT     1883
#define MQTT_CLIENT   "farm_001_esp"
#define UART_RX_PIN   15   // D8 = GPIO15
#define UART_TX_PIN   13   // D7 = GPIO13
#define UART_BAUD     115200
```

**STM32端**（uart_bridge.h）：
- USART2 PA2(TX) → ESP8266 D8(GPIO15/RX)
- USART2 PA3(RX) ← ESP8266 D7(GPIO13/TX)
- UART协议：`SNS:{json}\n` 上行，`CMD:xxx\n` 下行

**QT端**：
```cpp
m_client->setHostname("124.223.5.91");
m_client->setPort(1883);
```

---

## 九、系统架构图

```
┌────────────────────────────────────────────────────────────────────────────┐
│                              用户访问层                                      │
│  ┌──────────────┐  ┌──────────────┐  ┌──────────────┐                     │
│  │  PC电脑      │  │  手机浏览器  │  │  平板电脑    │                     │
│  │  QT上位机    │  │  Web页面     │  │  Web页面     │                     │
│  └──────┬───────┘  └──────┬───────┘  └──────┬───────┘                     │
└─────────┼────────────────┼────────────────┼──────────────────────────────┘
          │ MQTT           │ HTTP           │ HTTP
          ▼                ▼                ▼
┌────────────────────────────────────────────────────────────────────────────┐
│                        腾讯云服务器（应用层）                                │
│  ┌─────────────────────────────────────────────────────────────────────┐  │
│  │                    Mosquitto MQTT Broker                            │  │
│  │                    smartfarm/* Topic路由                            │  │
│  └─────────────────────────────────────────────────────────────────────┘  │
│  ┌────────────────────┐  ┌────────────────────┐  ┌────────────────────┐  │
│  │ Flask Web服务      │  │ SQLite数据库       │  │ systemd进程管理    │  │
│  │ - REST API         │  │ - 传感器历史数据   │  │ - 开机自启         │  │
│  │ - Web页面          │  │ - 灌溉日志         │  │ - 崩溃重启         │  │
│  └────────────────────┘  └────────────────────┘  └────────────────────┘  │
└────────────────────────────────────────────────────────────────────────────┘
          ▲
          │ WiFi + MQTT over TCP
          │
┌─────────┴────────────────────────────────────────────────────────────────┐
│                           传输层                                           │
│  ┌────────────────────────────────────────────────────────────────────┐  │
│  │              ESP8266 (Arduino独立固件)                              │  │
│  │ - WiFi连接 + MQTT通信 + JSON转换（独立处理）                       │  │
│  │ - SoftwareSerial与STM32通信（D7/D8, 115200bps）                   │  │
│  │ - UART文本协议：SNS上行/CMD下行                                    │  │
│  └────────────────────────────────────────────────────────────────────┘  │
└─────────┬────────────────────────────────────────────────────────────────┘
          │ UART
          ▼
┌────────────────────────────────────────────────────────────────────────────┐
│                      感知层（嵌入式终端）                                    │
│  ┌────────────────────────────────────────────────────────────────────┐  │
│  │              STM32F103C8T6 + FreeRTOS 实时系统                      │  │
│  │  ┌──────────────────────────────────────────────────────────────┐  │  │
│  │  │ Task_Sensor │ Task_LCD │ Task_MQTT │ Task_Irrigation │ Task_Alarm│  │
│  │  │ Task_Rain   │ Task_Water│ Task_Key  │                 │           │  │
│  │  └──────────────────────────────────────────────────────────────┘  │  │
│  └────────────────────────────────────────────────────────────────────┘  │
│  ┌────────────┐ ┌────────────┐ ┌────────────┐ ┌────────────┐            │
│  │ DHT22      │ │ FC28       │ │ BH1750     │ │ MH-Z19B    │            │
│  │ 空气温湿度  │ │ 土壤湿度   │ │ 光照强度   │ │ CO2浓度    │            │
│  └────────────┘ └────────────┘ └────────────┘ └────────────┘            │
│  ┌────────────┐ ┌────────────┐ ┌────────────┐ ┌────────────┐            │
│  │ DS18B20    │ │ BMP180     │ │ LM393      │ │ YF-S201    │            │
│  │ 土壤温度   │ │ 大气压强   │ │ 雨滴检测   │ │ 水流计量   │            │
│  └────────────┘ └────────────┘ └────────────┘ └────────────┘            │
│  ┌────────────┐ ┌────────────┐ ┌────────────┐ ┌────────────┐            │
│  │ OLED显示   │ │ 继电器     │ │ 蜂鸣器     │ │ DS3231     │            │
│  │ 本地交互   │ │ +水泵      │ │ 声音报警   │ │ RTC时钟    │            │
│  └────────────┘ └────────────┘ └────────────┘ └────────────┘            │
└────────────────────────────────────────────────────────────────────────────┘
```
