daobaitou/STM32_SmartFarm/Code/STM32_SmartFarm/STM32_SmartFarm/Core/Inc/main.h

#define LED_Pin GPIO_PIN_13
#define LED_GPIO_Port GPIOC
#define RELAY_Pin GPIO_PIN_1
#define RELAY_GPIO_Port GPIOB
#define BUZZER_Pin GPIO_PIN_8
#define BUZZER_GPIO_Port GPIOB
#define ALARM_LED_Pin GPIO_PIN_9
#define ALARM_LED_GPIO_Port GPIOB
#define KEY1_Pin GPIO_PIN_12
#define KEY1_GPIO_Port GPIOB
#define KEY2_Pin GPIO_PIN_13
#define KEY2_GPIO_Port GPIOB
#define KEY3_Pin GPIO_PIN_14
#define KEY3_GPIO_Port GPIOB
#define KEY4_Pin GPIO_PIN_15
#define KEY4_GPIO_Port GPIOB
#define FAN_Pin GPIO_PIN_4
#define FAN_GPIO_Port GPIOA
#define POWER_DETECT_Pin GPIO_PIN_5
#define POWER_DETECT_GPIO_Port GPIOA
