daobaitou/STM32_SmartFarm/Code/STM32_SmartFarm/STM32_SmartFarm/Core/Src/main.c

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
/* Includes ------------------------------------------------------------------*/
#include "main.h"
#include "adc.h"
#include "usart.h"
#include "gpio.h"
#include "tim.h"

/* USER CODE BEGIN Includes */
#include <stdio.h>
#include "sensor_dht22.h"
#include "sensor_ds18b20.h"
#include "sensor_fc28.h"
#include "display_oled.h"
#include "sensor_bh1750.h"
#include "sensor_bmp180.h"
#include "sensor_yfs201.h"
#include "sensor_mhz19b.h"
#include "w25q_flash.h"
#include "storage_manager.h"
#include "usart2_driver.h"
#include "uart_bridge.h"
#include "servo_control.h"
#include "fan_control.h"
#include "power_detect.h"
#include "app_tasks.h"
/* USER CODE END Includes */


void SystemClock_Config(void);
/* USER CODE BEGIN 0 */
void vApplicationStackOverflowHook(TaskHandle_t xTask, char *pcTaskName)
{
    /* 直接操作寄存器发送，几乎不用栈 */
    uint32_t i;
    const char *msg = "!!!OVF:";
    while(*msg)
    {
        while(!(USART1->SR & USART_SR_TXE));
        USART1->DR = *msg++;
    }
    if(pcTaskName)
    {
        char c;
        while((c = *pcTaskName++))
        {
            while(!(USART1->SR & USART_SR_TXE));
            USART1->DR = c;
        }
    }
    while(!(USART1->SR & USART_SR_TXE));
    USART1->DR = '\r';
    while(!(USART1->SR & USART_SR_TXE));
    USART1->DR = '\n';

    HAL_GPIO_WritePin(GPIOC, GPIO_PIN_13, GPIO_PIN_RESET);
    for(i = 0; i < 2000000; i++);
    while(1);
}
/* USER CODE END 0 */

/**
  * @brief  The application entry point.
  * @retval int
  */
int main(void)
{

  /* MCU Configuration--------------------------------------------------------*/

  /* Reset of all peripherals, Initializes the Flash interface and the Systick. */
  HAL_Init();

  /* Configure the system clock */
  SystemClock_Config();

  /* Initialize all configured peripherals */
  MX_GPIO_Init();
  MX_USART1_UART_Init();
  MX_USART2_UART_Init();
  MX_USART3_UART_Init();
  MX_ADC1_Init();
  /* TIM4已由HAL_Init→HAL_InitTick自动配置，无需再调用MX_TIM4_Init */
  /* USER CODE BEGIN 2 */
  DHT22_Init();
  DS18B20_Init();
  FC28_Init();
  OLED_Init();
  BH1750_Init();
  HAL_StatusTypeDef bmp_ret = BMP180_Init();
  printf("BMP180 Init: %d\r\n", bmp_ret);
  YFS201_Init();
  MHZ19B_Init();

  /* Servo (TIM3 PWM) + Fan (PA4) */
  Servo_Init();
  Fan_Init();

  /* Power failure detection (PA5 EXTI) */
  PowerDetect_Init();

  /* W25Q Flash 初始化测试 */
  printf("\r\n=== W25Q Flash Test ===\r\n");
  W25Q_Info_t flash_info;
  if (W25Q_Init() == HAL_OK && W25Q_ReadID(&flash_info) == HAL_OK)
  {
      printf("W25Q: Manuf=0x%02X, ID=0x%04X, Size=%luKB\r\n",
             flash_info.manufacturer, flash_info.device_id, flash_info.capacity/1024);
  }
  else
  {
      printf("W25Q: Not detected\r\n");
  }

  /* 存储管理器初始化 */
  Storage_Init();
  SystemConfig_t config;
  if (Storage_LoadConfig(&config) == HAL_OK)
  {
      printf("Config: SoilThresh=%.0f~%.0f%%, Mode=%d\r\n",
             config.soil_threshold_low, config.soil_threshold_high, config.irrigation_mode);
  }
  else
  {
      printf("Config: Using defaults\r\n");
      Storage_SaveConfig(&config);
  }

  /* USART2 driver for ESP8266 */
  USART2_Driver_Init();
  printf("USART2 driver init OK\r\n");

  /* MQTT will be initialized by MQTT_Pub task after FreeRTOS starts */

  printf("FreeRTOS starting...\r\n");

  FreeRTOS_Init();
  vTaskStartScheduler();

  /* 不应到达此处 */
  printf("ERROR: Scheduler failed!\r\n");
  /* USER CODE END 2 */

  /* Infinite loop */
  /* USER CODE BEGIN WHILE */
  while (1)
  {
    /* USER CODE END WHILE */

    /* USER CODE BEGIN 3 */
  }
  /* USER CODE END 3 */
}

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
