daobaitou/STM32_SmartFarm/(commit log)

2026-04-17 v0: 阶段0完成 - 工程框架搭建 + LED闪烁验证
    - CubeMX配置: RCC(HSE 8MHz), SYS(SWD), PC13 GPIO输出
    - 时钟: HSE→PLL×9→72MHz, APB1 36MHz, APB2 72MHz
    - Keil编译: 0 Error 0 Warning
    - LED: PC13 1秒周期闪烁验证通过
    - 添加FreeRTOS内核源码(v202411.00)
    [STM32_SmartFarm.ioc, main.c, main.h]
2026-04-19 v1.1: 阶段1部分完成 - printf重定向 + DS18B20 + DHT22驱动
    - Module 1.1: USART1 printf重定向 (retarget.c, MicroLIB)
    - Module 1.2: DHT22温湿度驱动 (PA1, 直接寄存器操作, 脉冲宽度测量)
    - Module 1.3: DS18B20土壤温度驱动 (PA6, 直接CRL寄存器模式切换)
    - 添加接线说明文档
2026-04-19 v1.2: Module 1.7 FC28土壤湿度驱动 - ADC采集完成
    - CubeMX配置ADC1 CH0 (PA0)
    - FC28驱动: ADC单次转换, 原始值转湿度百分比
    - 空气中ADC~4095(0%), 校准阈值可后续调整
2026-04-20 v1.3: OLED显示 + BH1750光照 + GPIO模拟I2C
    - 新增OLED SSD1306驱动(I2C, 128x64, 批量刷新)
    - 新增BH1750光照传感器驱动(单次触发模式+数据校验)
    - 新增GPIO模拟I2C驱动(解决F103硬件I2C锁死问题)
    - OLED/BH1750改用软件I2C, 去掉HAL硬件I2C依赖
    - 软件I2C: 关中断保护时序 + 总线恢复 + 自动重试
    - 更新开发问题与解决方案汇总文档(10个问题)
    [STM32_SmartFarm.ioc, display_oled.c, display_oled.h, main.c, sensor_bh1750.c, sensor_bh1750.h, soft_i2c.c]
2026-04-20 v1.4: Module 1.8 BMP180大气压强传感器驱动完成
    - 新增sensor_bmp180.c/h: 软件I2C驱动(地址0x77)
    - 读取11个EPROM校准参数(AC1-AC6, B1, B2, MB, MC, MD)
    - 芯片ID校验(0x55)
    - Bosch补偿公式计算真实温度和气压
    - main.c集成BMP180初始化和读取
    - OLED显示气压和光照数据
2026-04-20 文档更新: 详细开发计划书进度标记
    - 标记已完成模块: printf, DHT22, DS18B20, BH1750, BMP180, FC28, OLED
    - 更新BH1750/BMP180说明为软件I2C
    - 更新OLED说明为批量刷新优化
    - 更新里程碑版本表添加实际完成日期
    - 更新目录结构添加Drivers/soft_i2c
2026-04-20 v1.5: YF-S201水流传感器 + 全传感器串口/OLED集成
    - 新增sensor_yfs201.c/h: EXTI脉冲计数驱动(PB0)
    - stm32f1xx_it.c添加EXTI0中断处理
    - main.c集成全部传感器统一读取+显示
    - 串口输出所有传感器数据(DHT22/DS18B20/FC28/BMP180/BH1750/YFS201)
    - OLED四行显示温湿度/土壤/气压/光照/水流
    - 循环周期2秒(DHT22最小采样间隔)
    - 引脚调整: YF-S201改用PB0, FC28保持PA0, 继电器改PB1
    - 更新接线说明文档和详细开发计划书
2026-04-20 v2.0: FreeRTOS集成 + 传感器任务调度完成
    - FreeRTOS内核(FreeRTOSv202411.00)移植到STM32F103C8T6
    - 重写HAL_InitTick()用TIM4替代SysTick，解决调度器启动前崩溃
    - 4个任务：Sensor(2s采集)/LCD(OLED刷新)/Print(串口)/LED(500ms闪烁)
    - 消息队列+I2C互斥量实现任务间数据传递与总线保护
    - HAL TIM模块启用(hal_tim.c/hal_tim_ex.c + HAL_TIM_MODULE_ENABLED)
    - BMP180移除未使用的MB校准参数
    - 更新开发问题汇总(问题11-13)和详细开发计划书
    [app_tasks.c, app_tasks.h, main.c, sensor_bmp180.c, tim.c, tim.h]
2026-04-21 v2.1: W25Q64 SPI Flash存储模块集成
    - 软件SPI驱动(soft_spi): PB3=CLK, PB4=MOSI, PB5=MISO, PA15=CS
    - W25Q Flash驱动: JEDEC ID读取/页写入/扇区擦除/状态等待
    - 存储管理层: 系统配置参数(Sector 0) + 传感器数据日志(Sector 1-2)
    - 已验证: W25Q64(Manuf=0xEF, ID=0x4017, 8MB), 配置读写正常
    - 更新接线说明文档(引脚总表+SPI总线+W25Q接线)
    - 更新详细开发计划书(里程碑v2.1+目录结构)
2026-04-22 v3.0: ESP8266 MQTT通信集成 + FreeRTOS稳定性修复
    新增模块:
    - usart2_driver: USART2环形缓冲区驱动(512B) + RX中断
    - esp8266_at: ESP8266 AT命令驱动(TCP模式)，互斥锁保护
    - esp_mqtt: MQTT 3.1.1协议手动编码(CONNECT/PUBLISH/SUBSCRIBE/PINGREQ)
    关键修复:
    - FreeRTOS中断优先级: configMAX_SYSCALL_INTERRUPT_PRIORITY 从11修正为(5<<4)=80
    - 任务栈溢出: Sensor 384→512字, LCD 256→384字, Print 128→192字, LED 64→128字
    - 栈溢出钩子: 改为直接写UART寄存器，避免printf二次溢出
    - 队列多消费者: Sensor任务发送3份数据到队列
    - MQTT_Init从main.c移入MQTT_Pub任务，避免阻塞FreeRTOS启动
    - USART2互斥锁: 防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
    [app_tasks.c, app_tasks.h, main.c, sensor_yfs201.c, usart.c, usart2_driver.c, usart2_driver.h]
2026-04-22 文档更新: 新增问题14~23 (ESP8266/MQTT集成问题与解决方案)
    新增10个问题记录:
    - 问题14: FreeRTOS中断优先级配置错误导致Hard Fault
    - 问题15: 多任务栈溢出导致系统停止
    - 问题16: 栈溢出钩子自身溢出无法输出任务名
    - 问题17: ESP-12E NodeMCU板载CH340信号冲突
    - 问题18: ESP-AT固件MQTT命令不可用
    - 问题19: FreeRTOS队列多消费者问题
    - 问题20: MQTT_Init阻塞调度器启动
    - 问题21: USART2多任务竞争
    - 问题22: YFS201脉冲计数为零(待查硬件)
    - 问题23: DHT22缺少上拉电阻
2026-04-22 文档: 中期检查报告内容（Markdown格式）
2026-05-12 v4.0: ESP8266独立MQTT架构重构
    架构变更:
    - ESP8266运行独立Arduino固件，自行处理WiFi+MQTT+JSON
    - STM32只负责传感器采集，通过简单UART文本协议与ESP8266交换数据
    - 释放STM32约2.6KB RAM，彻底解决内存不足导致的系统崩溃
    新增:
    - Code/ESP8266_MQTT_Bridge/: ESP8266 Arduino固件
    - PubSubClient MQTT通信
    - ArduinoJson v6 JSON转换
    - SoftwareSerial与STM32通信(D7/D8)
    - 自动WiFi/MQTT重连
    - uart_bridge.h/c: STM32侧UART协议收发
    - 发送: SNS:{compact_json}\n
    - 接收: CMD:MODE/PUMP/THRESH\n
    删除:
    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
2026-05-13 文档更新: v4.0架构重构记录 + DHT22修复
    - 新增问题24: STM32 RAM不足导致接上ESP8266后系统崩溃
    - 通用经验表新增: 架构分配、协议简化
    - 更新最后更新日期为2026-05-13
2026-05-13 文档更新: 开发计划书和技术方案同步至v4.0架构
    - 详细开发计划书: 阶段4重写为ESP8266独立Arduino固件架构，更新任务/队列/引脚配置，里程碑表格同步
    - 技术方案: ESP8266从AT被动模式改为独立固件，任务架构更新为UART_TX/RX，系统架构图更新
2026-05-13 修正技术方案文档: 保留全部设计功能，仅更新实际变更
    - 恢复Task_Key/Rain/WaterLevel/Alarm/Irrigation等计划任务
    - 恢复rain_event_queue/alarm_data_queue等消息队列设计
    - 仅保留ESP8266型号变更(ESP-01S→ESP-12E NodeMCU)
    - 仅保留实际部署信息(124.223.5.91:1883)
    - 仅保留数据流描述和端设备配置的实际变更
2026-05-14 v4.2: 灌溉控制+报警+CO2传感器集成+稳定性修复
    功能新增:
    - 灌溉控制任务(自动/手动模式, 按键控制, MQTT远程控制)
    - 声光报警模块(蜂鸣器PB8+LED PB9, 土壤过干报警)
    - MH-Z19B CO2传感器驱动(USART3, 9600bps, 预热+量程过滤)
    - 水泵控制驱动(PB1继电器)
    - 3个按键消抖扫描(KEY1模式/KEY2水泵/KEY3清除报警)
    修复:
    - DS18B20温度跳变: 添加CRC8校验读取完整9字节scratchpad
    - 自动灌溉误触发: 添加last_soil>0守卫防止无有效读数时开泵
    - HardFault诊断: stm32f1xx_it.c添加详细故障信息输出
    - 电源稳定性: 3.3V电池供电解决ESP8266峰值电流导致系统停止
    文档更新:
    - 开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
    [ESP8266_MQTT_Bridge.ino, alarm_driver.c, alarm_driver.h, app_tasks.c, app_tasks.h, main.c, main.h]
2026-05-15 v4.4: 风扇+舵机窗户+断电检测+稳定性修复
    新功能:
    - 风扇控制 (PA4, TB6612驱动, 自动温度触发)
    - 舵机窗户控制 (PA7, TIM3 PWM 50Hz, 自动湿度触发)
    - KEY4按键切换风扇+窗户状态
    - 断电检测 (LM393比较器 + PA5双沿EXTI中断)
    - MQTT新增 control/fan 和 control/window Topic
    稳定性修复:
    - Irrigation任务优先级提升至6(独占最高)
    - Irrigation任务用debug_print替代printf(避免栈溢出)
    - FreeRTOS堆从12KB增至15KB
    - 蜂鸣器GPIO改为NOPULL(解决一直响问题)
    - 按键消抖改为单次触发+短滴声确认
    - 详细开发计划书同步至v4.4
    - 接线说明文档更新(风扇/舵机/断电检测/MOS水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
    [ESP8266_MQTT_Bridge.ino, alarm_driver.c, alarm_driver.h, app_tasks.c, app_tasks.h, config.h, fan_control.c, fan_control.h]
2026-05-17 v5.1: Flask Web部署 + 历史页面Chart.js曲线设计 + 文档更新
    Flask Web端（腾讯云124.223.5.91）:
    - Gunicorn+Nginx+SQLite+systemd部署完成
    - MQTT订阅传感器数据实时存储
    - REST API: /api/latest, /api/history, /api/control
    - 仪表盘: 9传感器卡片+2秒自动刷新
    - 历史页面: Chart.js趋势曲线+统计卡片+折叠表格
    - 远程控制: 模式/水泵/风扇/窗户/阈值
    STM32端改进:
    - FC28 ADC采样时间优化(55.5周期+5次平均)
    - 传感器采集频率优化(DS18B20+BH1750每6s, BMP180每18s, CO2每30s)
    - 断电检测模块(power_detect.c/h)
    - 水泵控制改为MOS驱动(高电平ON)
    - 详细开发计划书同步至v5.1
    - CLAUDE.md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
2026-05-17 添加README文件
2026-05-17 README: Mermaid架构图 + 移除隐私信息
2026-05-17 v5.2: QT上位机 + Flask控制命令修复(gunicorn临时MQTT客户端)
    - QT上位机完整实现：REST API轮询、9传感器卡片、QtCharts历史曲线、控制面板
    - 使用MinGW GCC 13.1编译通过（GCC 11.2与Qt6.5 C++17不兼容）
    - Flask mqtt_publish改为临时客户端发布，修复gunicorn fork后MQTT连接失效问题
    - 控制命令已验证可正常到达MQTT Broker
    [apiclient.cpp, apiclient.h, database.cpp, database.h]
2026-05-17 fix: 远程控制命令被自动逻辑覆盖的问题
    根因：自动模式下STM32每200ms检查阈值，手动控制命令被立即覆盖
    修复：
    - Web端：设备按钮点击前自动发送MANUAL模式命令
    - QT端：控制面板操作时同步切换手动模式
    - STM32端：收到设备控制命令时自动设置irrigation_mode=1
    - Web控制页增加模式指示器，区分setMode和controlDevice
    [app_tasks.c]
2026-05-17 fix: UART协议v2.0 - 降波特率9600 + XOR校验 + ACK确认
    根因: ESP8266 SoftwareSerial TX在115200不可靠，STM32收到乱码
    - 波特率降至9600（SoftwareSerial可靠工作）
    - 帧格式: $content*XX\n (XX=XOR校验和)
    - STM32收到命令后发送ACK确认
    - ESP8266重发机制(3次重试，等待ACK)
    - debug_print替代printf避免栈溢出
    需要重新烧录: STM32(Keil) + ESP8266(Arduino IDE)
    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
    [ESP8266_MQTT_Bridge.ino, app_tasks.c, config.h, uart_bridge.c, uart_bridge.h, usart.c]
2026-05-17 fix: debug_print声明顺序 - 移到文件顶部避免隐式声明冲突
    [app_tasks.c]
2026-05-17 fix: UART栈溢出 - 单buffer格式化 + 增大任务栈512words
    根因: send_frame嵌套调用 + snprintf浮点(~1.5KB) 超过256words栈
    - UART_Bridge_SendSensorData只用一个buffer完成帧格式化
    - send_ack改为直接发送，不调用send_frame
    - UART_TX任务栈 256→512 words
    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
    [app_tasks.c, uart_bridge.c]
2026-05-17 fix: 恢复UART波特率为115200，9600导致ESP8266无法通信
2026-05-17 fix: 恢复简单UART协议(无校验ACK)，解决9600通信失败
    - 移除XOR校验和ACK机制，恢复CMD:xxx\n简单格式
    - ESP8266 v2.1简化版，115200波特率
    - uart_bridge.c单buffer格式化，避免栈溢出
    [ESP8266_MQTT_Bridge.ino, uart_bridge.c, uart_bridge.h]
2026-05-17 fix: 恢复原始UART协议 + 添加调试计数器定位接收问题
    - uart_bridge.c恢复原始格式(SNS/CMD简单协议)
    - UART_RX任务增加字节计数器，每5秒打印接收数量
    - 如果计数为0，说明STM32未收到ESP8266 TX数据
    - 修复UART_RX任务case语句错误(CMD_WINDOW_CLOSE)
    - UART_RX栈增至256words(使用printf)
    [ESP8266_MQTT_Bridge.ino, app_tasks.c, uart_bridge.c, uart_bridge.h]
2026-05-17 debug: 打印UART接收到的每行原始内容定位解析失败原因
2026-05-17 fix: 恢复原始任务栈大小，去掉printf避免栈溢出
    - UART_TX: 512→256 words, UART_RX: 256→128 words
    - UART_RX任务改用debug_print(直接寄存器输出)
    - uart_bridge.c去掉printf调试行(128words栈不够)
    - 保留字节计数器(rx_byte_count)供诊断
    [app_tasks.c, uart_bridge.c]
