daobaitou/STM32_SmartFarm/(notices)

Notices in the files:
Code/STM32_SmartFarm/STM32_SmartFarm/Core/Src/usart.c:
Copyright (c) 2026 STMicroelectronics.
All rights reserved.
This software is licensed under terms that can be found in the LICENSE file
